DenovoSciences/PCB-PREP400/BOM - GenesisV2/SA1000139 - BOM - Assy, PCBA, Daughter, Genesis V2-Rev_5.xlsx

Sheet: Celsee BOM
 |  |  |  | Document Title | SA1000139 - BOM - Assy, PCBA, Daughter, Genesis V2 |  |  |  |  |  | REV | 5 | This Area Below Is Intentionally Not Printed
 |  |  |  | Document Type | Bill of Materials |  |  |  |  |  | Sheet 1 of 1
 |  |  |  | Issued By | Engineering |  |  |  |  |  | WO size
PLYMOUTH, MICHIGAN 48170 |  |  |  | Celsee Part # | SA1000139 |  |  |  |  |  | WO #
 |  |  |  | Product Desc. | Assy, PCBA, Daughter, Genesis V2
Find No. | Part Number | Part Number Rev | Description |  |  | QTY for 1 Unit | UoM | QTY for WO | Actuals | Celsee Lot/WO # (if available) | Supplier Lot # (if available) | Special Notes | Manufacturer | Manufacturer Part Number | 1st Vendor/Supplier | 1st Vendor/Supplier Part Number | 2nd Vendor/Supplier | 2nd Vendor/Supplier Part Number
1 | 10000387 | 2 | PCB, Prep400 |  |  | 1 | Each | 0 |  |  |  |  |  |  | PCB Universe | 10000387 rev A
2 | 16000004 | OTS | CAP CER 0.1UF 50V X7R 0603 | CAP CER 0.1UF 50V X7R 0603 | CAP CER 0.1UF 50V X7R 0603 | 40 | Each | 0 |  |  |  | C1, C2, C5, C8, C9, C12, C13, C14, C15, C16, C17, C18, C19, C20, C22, C23, C24, C25, C27, C28, C29, C30, C32, C33, C34, C35, C37, C39, C41, C43, C49, C51, C53, C55, C61, C63, C109, C110, C118, C137 | Murata | GCM188R71H104KA57J | Digi-Key | 490-8020-1-ND | Digi-Key
3 | 16000068 | OTS | CAP ALUM POLY 100UF 20% 50V SMD | CAP ALUM POLY 100UF 20% 50V SMD | CAP ALUM POLY 100UF 20% 50V SMD | 4 | Each | 0 |  |  |  | C21, C26, C31, C36 | Panasonic | EEH-ZC1H101V | Digi-Key | P19837CT-ND | Digi-Key | 50PFV100M10X10.5CT-ND
4 | 16000069 | OTS | CAP CER 10UF 10V X5R 0603 | CAP CER 10UF 10V X5R 0603 | CAP CER 10UF 10V X5R 0603 | 4 | Each | 0 |  |  |  | C38, C40, C42, C44 | TDK | C1608X5R1A106K080AC | Digi-Key | 445-7486-1-ND | Digi-Key | 1276-1038-1-ND
5 | 16000070 | OTS | CAP CER 0.22UF 50V X7R 0603 | CAP CER 0.22UF 50V X7R 0603 | CAP CER 0.22UF 50V X7R 0603 | 4 | Each | 0 |  |  |  | C45, C46, C47, C48 | Samsung | CL10B224KB8VPNC | Digi-Key | 1276-6600-1-ND | Digi-Key
6 | 16000071 | OTS | CAP CER 47UF 6.3V X5R 0805 | CAP CER 47UF 6.3V X5R 0805 | CAP CER 47UF 6.3V X5R 0805 | 4 | Each | 0 |  |  |  | C50, C52, C54, C56 | Samsung | CL21A476MQ9LRNC | Digi-Key | 1276-2419-1-ND | Digi-Key
7 | 16000072 | OTS | CAP CER 10000PF 50V X7R 0603 | CAP CER 10000PF 50V X7R 0603 | CAP CER 10000PF 50V X7R 0603 | 36 | Each | 0 |  |  |  | C57, C58, C59, C60, C119, C120, C121, C124, C127, C128, C131, C138, C139, C140, C141, C142, C143, C144, C145, C146, C147, C148, C149, C150, C151, C152, C153, C154, C155, C156, C157, C158, C159, C161, C171, C172 | Murata | GCM188R71H103KA37D | Digi-Key | 490-4778-1-ND | Digi-Key
8 | 16000094 | OTS | DIODE SCHOTTKY 30V 200MA SOT23-3 | DIODE SCHOTTKY 30V 200MA SOT23-3 | DIODE SCHOTTKY 30V 200MA SOT23-3 | 2 | Each | 0 |  |  |  | D1, D3 | Diodes Inc. | BAT54-7-F | Digi-Key | BAT54-FDICT-ND | Digi-Key | BAT54E6327HTSA1
9 | 16000073 | OTS | DIODE ZENER 3.3V 350MW SOT23-3 | DIODE ZENER 3.3V 350MW SOT23-3 | DIODE ZENER 3.3V 350MW SOT23-3 | 2 | Each | 0 |  |  |  | D2, D4 | Micro Commercial | BZX84C3V3-TP | Digi-Key | BZX84C3V3-TPMSCT-ND | Digi-Key
10 | 16000074 | OTS | DIODE GEN PURP 100V 1A SMA | DIODE GEN PURP 100V 1A SMA | DIODE GEN PURP 100V 1A SMA | 6 | Each | 0 |  |  |  | D9, D10, D11, D12, D13, D14 | ON Semi | ES1B | Digi-Key | ES1BFSCT-ND | Digi-Key | CD214A-F1100CT-ND
11 | 16000056 | OTS | DIODE ARRAY SCHOTTKY 30V SOT23-3 | DIODE ARRAY SCHOTTKY 30V SOT23-3 | DIODE ARRAY SCHOTTKY 30V SOT23-3 | 6 | Each | 0 |  |  |  | D15, D16, D17, D18, D27, D28 | ON Semi | BAT54SLT1G | Digi-Key | BAT54SLT1GOSCT-ND | Digi-Key
12 | 16000075 | OTS | DIODE ARRAY GP 70V 200MA SOT23-3 | DIODE ARRAY GP 70V 200MA SOT23-3 | DIODE ARRAY GP 70V 200MA SOT23-3 | 4 | Each | 0 |  |  |  | D19, D20, D21, D22 | Taiwan Semi | BAV99 RFG | Digi-Key | BAV99RFGCT-ND | Digi-Key
13 | 16000095 | OTS | TVS DIODE 12V 19V SMB | TVS DIODE 12V 19V SMB | TVS DIODE 12V 19V SMB | 8 | Each | 0 |  |  |  | D31, D32, D35, D36, D37, D38, D39, D40 | Littlefuse | SACB12 | Digi-Key | SACB12CT-ND | Digi-Key | SMBJ12ABCT-ND
14 | 16000098 | OTS | SENSOR PRESS 5PSI DIFF 3.3V SMD | SENSOR PRESS 5PSI DIFF 3.3V SMD | SENSOR PRESS 5PSI DIFF 3.3V SMD | 2 | Each | 0 |  |  |  | IC1, IC4 | Honeywell | SSCMRRN005PDAA3 | Digi-Key | 480-5530-ND | Digi-Key
15 | 16000020 | OTS | IC MOTOR DRIVER SPI 28HTSSOP | IC MOTOR DRIVER SPI 28HTSSOP | IC MOTOR DRIVER SPI 28HTSSOP | 4 | Each | 0 |  |  |  | IC5, IC6, IC7, IC8 | STMicro | L6472H | Digi-Key | 497-14690-5-ND | Digi-Key | 497-14775-5-ND
16 | 16000076 | OTS | IC MOTOR DRIVER PAR 20-SOIC | IC MOTOR DRIVER PAR 20-SOIC | IC MOTOR DRIVER PAR 20-SOIC | 1 | Each | 0 |  |  |  | IC9 | STMicro | L293DD | Digi-Key | 497-1390-5-ND | Digi-Key | 497-2937-1-ND
17 | 16000021 | OTS | CONN HEADER VERT 2POS .100 30AU | CONN HEADER VERT 2POS .100 30AU | CONN HEADER VERT 2POS .100 30AU | 7 | Each | 0 |  |  |  | J3, J8, J9, J10, J11, J12, J13 | TE | 3-641215-2 | Digi-Key | A30786-ND | Digi-Key | WM2700-ND
18 | 16000022 | OTS | CONN HEADER VERT 3POS .100 30AU | CONN HEADER VERT 3POS .100 30AU | CONN HEADER VERT 3POS .100 30AU | 6 | Each | 0 |  |  |  | J4, J5, J14, J15, J16, J17 | TE | 3-641215-3 | Digi-Key | A30787-ND | Digi-Key | WM2701-ND
19 | 16000023 | OTS | CONN HEADER VERT 4POS .100 30AU | CONN HEADER VERT 4POS .100 30AU | CONN HEADER VERT 4POS .100 30AU | 4 | Each | 0 |  |  |  | J18, J19, J20, J21 | TE | 3-641215-4 | Digi-Key | A30788-ND | Digi-Key | WM2746-ND
20 | 16000077 | OTS | CONN HEADER VERT 5POS .100 30AU | CONN HEADER VERT 5POS .100 30AU | CONN HEADER VERT 5POS .100 30AU | 2 | Each | 0 |  |  |  | J22, J23 | TE | 3-641215-5 | Digi-Key | A30789-ND | Digi-Key | WM2703-ND
21 | 16000078 | OTS | CONN HEADER 2POS .100" SNGL | CONN HEADER 2POS .100" SNGL | CONN HEADER 2POS .100" SNGL | 6 | Each | 0 |  |  |  | JP3, JP4, JP7, JP8, JP9, JP10 | Samtec | TSW-102-07-F-S | Digi-Key | SAM10844-ND | Digi-Key | SAM1031-02-ND
22 | 16000079 | OTS | CONN JUMPER SHORTING .100" GOLD | CONN JUMPER SHORTING .100" GOLD | CONN JUMPER SHORTING .100" GOLD | 6 | Each | 0 |  |  |  | JP3, JP4, JP7, JP8, JP9, JP10 (Populate Jumper on Headers, to short Pin1 and Pin2) | Sullins | QPC02SXGN-RC | Digi-Key | S9337-ND | Digi-Key | S9001-ND
23 | 16000080 | OTS | .025" BOARD SPACERS | .025" BOARD SPACERS | .025" BOARD SPACERS | 1 | Each | 0 |  |  |  | P1 | Samtec | DW-11-11-F-D-665 | Digi-Key | DW-11-11-F-D-665-ND | Digi-Key
24 | 16000081 | OTS | MOSFET N-CH 60V 2.8A SOT-223 | MOSFET N-CH 60V 2.8A SOT-223 | MOSFET N-CH 60V 2.8A SOT-223 | 6 | Each | 0 |  |  |  | Q2, Q3, Q4, Q5, Q6, Q7 | ON Semi | FQT13N06LTF | Digi-Key | FQT13N06LTFCT-ND | Digi-Key
25 | 16000082 | OTS | RES SMD 330 OHM 1% 1/10W 0603 | RES SMD 330 OHM 1% 1/10W 0603 | RES SMD 330 OHM 1% 1/10W 0603 | 6 | Each | 0 |  |  |  | R19, R20, R21, R22, R27, R28 | Samsung | RC1608F331CS | Digi-Key | 1276-4604-1-ND | Digi-Key | CR0603-FX-3300ELFCT-ND
26 | 16000083 | OTS | RES SMD 10K OHM 1% 1/10W 0603 | RES SMD 10K OHM 1% 1/10W 0603 | RES SMD 10K OHM 1% 1/10W 0603 | 9 | Each | 0 |  |  |  | R23, R24, R25, R26, R29, R30, R39, R41, R43 | Panasonic | ERJ-3EKF1002V | Digi-Key | P10.0KHCT-ND | Digi-Key
27 | 16000096 | OTS | RES SMD 100 OHM 1% 1/10W 0603 | RES SMD 100 OHM 1% 1/10W 0603 | RES SMD 100 OHM 1% 1/10W 0603 | 16 | Each | 0 |  |  |  | R3, R5, R31, R33, R35, R37, R45, R47, R59, R60, R63, R64, R65, R66, R67, R68 | Panasonic | ERJ-3EKF1000V | Digi-Key | P100HCT-ND | Digi-Key
28 | 16000097 | OTS | RES SMD 1.5K OHM 1% 1/10W 0603 | RES SMD 1.5K OHM 1% 1/10W 0603 | RES SMD 1.5K OHM 1% 1/10W 0603 | 2 | Each | 0 |  |  |  | R4, R6 | Samsung | RC1608F152CS | Digi-Key | 1276-4660-1-ND | Digi-Key | CR0603-FX-1501ELFCT-ND
29 | 16000084 | OTS | RES SMD 100K OHM 1% 1/10W 0603 | RES SMD 100K OHM 1% 1/10W 0603 | RES SMD 100K OHM 1% 1/10W 0603 | 6 | Each | 0 |  |  |  | R11, R12, R55, R56, R73, R76 | Panasonic | ERJ-3EKF1003V | Digi-Key | P100KHCT-ND | Digi-Key
30 | 16000037 | OTS | RES SMD 1K OHM 1% 1/10W 0603 | RES SMD 1K OHM 1% 1/10W 0603 | RES SMD 1K OHM 1% 1/10W 0603 | 8 | Each | 0 |  |  |  | R15, R18, R32, R34, R36, R38, R46, R48 | Panasonic | ERJ-3EKF1001V | Digi-Key | P1.00KHCT-ND | Digi-Key
31 | 16000085 | OTS | RES SMD 39K OHM 1% 1/10W 0603 | RES SMD 39K OHM 1% 1/10W 0603 | RES SMD 39K OHM 1% 1/10W 0603 | 1 | Each | 0 |  |  |  | R40 | Panasonic | ERJ-3EKF3902V | Digi-Key | P39.0KHCT-ND | Digi-Key
32 | 16000060 | OTS | RES SMD 0 OHM JUMPER 1/10W 0603 | RES SMD 0 OHM JUMPER 1/10W 0603 | RES SMD 0 OHM JUMPER 1/10W 0603 | 2 | Each | 0 |  |  |  | R71, R72 | Panasonic | ERJ-3GEY0R00V | Digi-Key | P0.0GCT-ND | Digi-Key | RMCF0603ZT0R00CT-ND
33 | 16000086 | OTS | PC TEST POINT COMPACT BLACK | PC TEST POINT COMPACT BLACK | PC TEST POINT COMPACT BLACK | 4 | Each | 0 |  |  |  | TP19, TP20, TP21, TP22 | Keystone | 5006 | Digi-Key | 36-5006-ND | Digi-Key | 36-5123-ND
34 | 16000087 | OTS | CONN HEADER FMAL 12PS.1" DL GOLD | CONN HEADER FMAL 12PS.1" DL GOLD | CONN HEADER FMAL 12PS.1" DL GOLD | 1 | Each | 0 |  |  |  | U1 Goes to U1-4 (12-pos, Mate: 609-3213-ND) | Sullins | PPPC062LFBN-RC | Digi-Key | S7109-ND | Digi-Key | S7074-ND
35 | 16000088 | OTS | CONN HEADER FMAL 16PS.1" DL GOLD | CONN HEADER FMAL 16PS.1" DL GOLD | CONN HEADER FMAL 16PS.1" DL GOLD | 2 | Each | 0 |  |  |  | U1 Goes to U1-1 and U1-3 (16-pos, Mate: 609-3389-ND) | Sullins | PPPC082LFBN-RC | Digi-Key | S7111-ND | Digi-Key | S7076-ND
36 | 16000089 | OTS | CONN HEADER FEM 20POS.1" DL GOLD | CONN HEADER FEM 20POS.1" DL GOLD | CONN HEADER FEM 20POS.1" DL GOLD | 1 | Each | 0 |  |  |  | U1 Goes to U1-2 (20-pos, Mate: 609-3214-ND) | Sullins | PPPC102LFBN-RC | Digi-Key | S6106-ND | Digi-Key | S7078-ND
37 | 16000090 | OTS | FREEDOM BOARD KINETIS L | FREEDOM BOARD KINETIS L | FREEDOM BOARD KINETIS L | 1 | Each | 0 |  |  |  | U1 Motherboard. Remove D8, D11 from FRDM-KL25Z | NXP | FRDM-KL25Z | Digi-Key | FRDM-KL25Z-ND | Digi-Key
38 | 16000091 | OTS | CONN HEADER 12POS .100 STR 15AU | CONN HEADER 12POS .100 STR 15AU | CONN HEADER 12POS .100 STR 15AU | 1 | Each | 0 |  |  |  | U1 Goes to J10 of FRDM-KL25Z | Amphenol | 67996-212HLF | Digi-Key | 609-3213-ND | Digi-Key | 609-3204-ND, 609-3219-ND
39 | 16000092 | OTS | CONN HEADER 16POS .100 STR 15AU |  |  | 2 | Each | 0 |  |  |  | U1 Goes to J1, J9 of FRDM-KL25Z | Amphenol | 67996-216HLF | Digi-Key | 609-3389-ND | Digi-Key | 609-3205-ND, 609-3220-ND
40 | 16000093 | OTS | CONN HEADER 20POS .100 STR 15AU | CONN HEADER 16POS .100 STR 15AU | CONN HEADER 16POS .100 STR 15AU | 1 | Each | 0 |  |  |  | U1 Goes to J2 of FRDM-KL25Z | Amphenol | 67996-220HLF | Digi-Key | 609-3214-ND | Digi-Key | 609-3206-ND, 609-3221-ND
Comments: |  |  |  |  |  |  |  |  |  |  |  |  | This Area Above Is Intentionally Not Printed
Signature: |  |  |  |  | Date:
PROPRIETARY AND CONFIDENTIAL: The information contained in this document is the property of Celsee, Inc. Any reproduction in whole or in part without the written permission of Celsee, Inc is prohibited. PRINTED COPIES OF THIS DOCUMENT ARE NOT CONTROLLED

Sheet: Daughter Board, Rev 5, 20181220
Bill of Material
Product: | Genesis V2
Revision: | 5
PCBA PartNum: | SA1000139 | Rev. 4
PCB PartNum: | 10000387 | Rev. 2
CelseePartNum | Rev. | References | Quantity | Description | Mfg | MfgPartNum | DigikeyPartNum | AltDigikeyPartNum | Notes
16000004 | N/A | C1, C2, C5, C8, C9, C12, C13, C14, C15, C16, C17, C18, C19, C20, C22, C23, C24, C25, C27, C28, C29, C30, C32, C33, C34, C35, C37, C39, C41, C43, C49, C51, C53, C55, C61, C63, C109, C110, C118, C137 | 40 | CAP CER 0.1UF 50V X7R 0603 | Murata | GCM188R71H104KA57J | 490-8020-1-ND
 |  | (C3, C4, C6, C7, C10, C11, C62, C64, C65, C66, C67, C68, C70, C71, C72, C73, C75, C76, C77, C78, C80, C81, C82, C83, C85, C87, C89, C91, C97, C99, C101, C103, C111, C112, C116, C132, C163, C165, C167, C169, C191, C193, C195, C197)* | 44 |  |  |  |  |  | *Do Not Populate
 |  | (C113)* | 1 | CAP CER 0.1UF 100V X7R 1206 | Kemet | C1206C104K1RACAUTO | 399-7008-1-ND | 445-5840-1-ND | *Do Not Populate
16000068 | N/A | C21, C26, C31, C36 | 4 | CAP ALUM POLY 100UF 20% 50V SMD | Panasonic | EEH-ZC1H101V | P19837CT-ND | 50PFV100M10X10.5CT-ND
 |  | (C69, C74, C79, C84)* | 4 |  |  |  |  |  | *Do Not Populate
16000069 | N/A | C38, C40, C42, C44 | 4 | CAP CER 10UF 10V X5R 0603 | TDK | C1608X5R1A106K080AC | 445-7486-1-ND | 1276-1038-1-ND
 |  | (C86, C88, C90, C92)* | 4 |  |  |  |  |  | *Do Not Populate
16000070 | N/A | C45, C46, C47, C48 | 4 | CAP CER 0.22UF 50V X7R 0603 | Samsung | CL10B224KB8VPNC | 1276-6600-1-ND
 |  | (C93, C94, C95, C96)* | 4 |  |  |  |  |  | *Do Not Populate
16000071 | N/A | C50, C52, C54, C56 | 4 | CAP CER 47UF 6.3V X5R 0805 | Samsung | CL21A476MQ9LRNC | 1276-2419-1-ND
 |  | (C136, C98, C100, C102, C104)* | 5 |  |  |  |  |  | *Do Not Populate
 |  | (C115)* | 1 | CAP CER 47UF 6.3V X5R 1206 | Samsung | CL31A476KQHNNNE | 1276-3062-1-ND |  | *Do Not Populate
16000072 | N/A | C57, C58, C59, C60, C119, C120, C121, C124, C127, C128, C131, C138, C139, C140, C141, C142, C143, C144, C145, C146, C147, C148, C149, C150, C151, C152, C153, C154, C155, C156, C157, C158, C159, C161, C171, C172 | 36 | CAP CER 10000PF 50V X7R 0603 | Murata | GCM188R71H103KA37D | 490-4778-1-ND
 |  | (C105, C106, C107, C108, C117, C122, C123, C125, C126, C129, C130, C133, C134, C160, C162, C164, C166, C168, C170, C173, C174, C175, C176, C177, C178, C179, C180, C181, C182, C183, C184, C185, C186, C187, C188, C189, C190, C192, C194, C196, C198)* | 41 |  |  |  |  |  | *Do Not Populate
 |  | (C114)* | 1 | CAP CER 10000PF 200V X7R 1206 | AVX | 12062C103K4T2A | 478-9898-1-ND |  | *Do Not Populate
 |  | (C135)* | 1 | CAP CER 10PF 50V C0G/NP0 0603 | Samsung | CL10C100JB81PNC | 1276-2153-1-ND |  | *Do Not Populate
16000094 | N/A | D1, D3 | 2 | DIODE SCHOTTKY 30V 200MA SOT23-3 | Diodes Inc. | BAT54-7-F | BAT54-FDICT-ND | BAT54E6327HTSA1
 |  | (D5, D7)* | 2 |  |  |  |  |  | *Do Not Populate
16000073 | N/A | D2, D4 | 2 | DIODE ZENER 3.3V 350MW SOT23-3 | Micro Commercial | BZX84C3V3-TP | BZX84C3V3-TPMSCT-ND
 |  | (D6, D8)* | 2 |  |  |  |  |  | *Do Not Populate
16000074 | N/A | D9, D10, D11, D12, D13, D14 | 6 | DIODE GEN PURP 100V 1A SMA | ON Semi | ES1B | ES1BFSCT-ND | CD214A-F1100CT-ND
16000056 | N/A | D15, D16, D17, D18, D27, D28 | 6 | DIODE ARRAY SCHOTTKY 30V SOT23-3 | ON Semi | BAT54SLT1G | BAT54SLT1GOSCT-ND
 |  | (D29, D30)* | 2 |  |  |  |  |  | *Do Not Populate
16000075 | N/A | D19, D20, D21, D22 | 4 | DIODE ARRAY GP 70V 200MA SOT23-3 | Taiwan Semi | BAV99 RFG | BAV99RFGCT-ND
 |  | (D23, D24, D25, D26)* | 4 |  |  |  |  |  | *Do Not Populate
16000095 | N/A | D31, D32, D35, D36, D37, D38, D39, D40 | 8 | TVS DIODE 12V 19V SMB | Littlefuse | SACB12 | SACB12CT-ND | SMBJ12ABCT-ND
 |  | (D33, D34, D41, D42)* | 4 |  |  |  |  |  | *Do Not Populate
16000098 | N/A | IC1, IC4 | 2 | SENSOR PRESS 5PSI DIFF 3.3V SMD | Honeywell | SSCMRRN005PDAA3 | 480-5530-ND
 |  | (IC2, IC3)* | 2 |  |  |  |  |  | *Do Not Populate
16000020 | N/A | IC5, IC6, IC7, IC8 | 4 | IC MOTOR DRIVER SPI 28HTSSOP | STMicro | L6472H | 497-14690-5-ND | 497-14775-5-ND
 |  | (IC11, IC12, IC13, IC14)* | 4 |  |  |  |  |  | *Do Not Populate
16000076 | N/A | IC9 | 1 | IC MOTOR DRIVER PAR 20-SOIC | STMicro | L293DD | 497-1390-5-ND | 497-2937-1-ND
 |  | (IC10)* | 1 |  |  |  |  |  | *Do Not Populate
 |  | (J1)* | 1 | CONN HEADER 4POS VERT .156 GOLD | TE | 3-641209-4 | A105038-ND | WM5226-ND | *Do Not Populate
16000021 | N/A | J3, J8, J9, J10, J11, J12, J13 | 7 | CONN HEADER VERT 2POS .100 30AU | TE | 3-641215-2 | A30786-ND | WM2700-ND
 |  | (J2)* | 1 |  |  |  |  |  | *Do Not Populate
16000022 | N/A | J4, J5, J14, J15, J16, J17 | 6 | CONN HEADER VERT 3POS .100 30AU | TE | 3-641215-3 | A30787-ND | WM2701-ND
 |  | (J6, J7)* | 2 |  |  |  |  |  | *Do Not Populate
16000023 | N/A | J18, J19, J20, J21 | 4 | CONN HEADER VERT 4POS .100 30AU | TE | 3-641215-4 | A30788-ND | WM2746-ND
 |  | (J26, J27, J28, J29)* | 4 |  |  |  |  |  | *Do Not Populate
16000077 | N/A | J22, J23 | 2 | CONN HEADER VERT 5POS .100 30AU | TE | 3-641215-5 | A30789-ND | WM2703-ND
 |  | (J24, J25)* | 2 |  |  |  |  |  | *Do Not Populate
16000078 | N/A | JP3, JP4, JP7, JP8, JP9, JP10 | 6 | CONN HEADER 2POS .100" SNGL | Samtec | TSW-102-07-F-S | SAM10844-ND | SAM1031-02-ND | Jumper Header
16000079 | N/A |  | 6 | CONN JUMPER SHORTING .100" GOLD | Sullins | QPC02SXGN-RC | S9337-ND | S9001-ND | Populate Jumper on Headers
 |  | (JP1, JP2, JP5, JP6, JP11, JP12)* | 6 |  |  |  |  |  | *Do Not Populate
 |  | (L1)* | 1 | FERRITE BEAD 50 OHM 1206 1LN | Murata | BLM31SN500SH1L | 490-13268-1-ND | 490-13270-1-ND | *Do Not Populate
 |  | (L2, L3, L4, L5, L6, L7, L8, L9, L10, L11, L12)* | 11 | FERRITE BEAD 1 KOHM 0805 1LN | TDK | MPZ2012S102ATD25 | 445-172904-1-ND | 445-5223-1-ND | *Do Not Populate
16000080 | N/A | P1 | 1 | .025" BOARD SPACERS | Samtec | DW-11-11-F-D-665 | DW-11-11-F-D-665-ND |  | Not stocked. Long lead time component.
16000081 | N/A | Q2, Q3, Q4, Q5, Q6, Q7 | 6 | MOSFET N-CH 60V 2.8A SOT-223 | ON Semi | FQT13N06LTF | FQT13N06LTFCT-ND
 |  | (Q1)* | 1 |  |  |  |  |  | *Do Not Populate
16000082 | N/A | R19, R20, R21, R22, R27, R28 | 6 | RES SMD 330 OHM 1% 1/10W 0603 | Samsung | RC1608F331CS | 1276-4604-1-ND | CR0603-FX-3300ELFCT-ND
 |  | (R1)* | 1 |  |  |  |  |  | *Do Not Populate
16000083 | N/A | R23, R24, R25, R26, R29, R30, R39, R41, R43 | 9 | RES SMD 10K OHM 1% 1/10W 0603 | Panasonic | ERJ-3EKF1002V | P10.0KHCT-ND
 |  | (R2, R42, R44, R49)* | 4 |  |  |  |  |  | *Do Not Populate
16000096 | N/A | R3, R5, R31, R33, R35, R37, R45, R47, R59, R60, R63, R64, R65, R66, R67, R68 | 16 | RES SMD 100 OHM 1% 1/10W 0603 | Panasonic | ERJ-3EKF1000V | P100HCT-ND
 |  | (R7, R9, R51, R53, R61, R62, R69, R70)* | 8 |  |  |  |  |  | *Do Not Populate
16000097 | N/A | R4, R6 | 2 | RES SMD 1.5K OHM 1% 1/10W 0603 | Samsung | RC1608F152CS | 1276-4660-1-ND | CR0603-FX-1501ELFCT-ND
 |  | (R8, R10)* | 2 |  |  |  |  |  | *Do Not Populate
16000084 | N/A | R11, R12, R55, R56, R73, R76 | 6 | RES SMD 100K OHM 1% 1/10W 0603 | Panasonic | ERJ-3EKF1003V | P100KHCT-ND
 |  | (R13, R14, R57, R58, R74, R75)* | 6 |  |  |  |  |  | *Do Not Populate
16000037 | N/A | R15, R18, R32, R34, R36, R38, R46, R48 | 8 | RES SMD 1K OHM 1% 1/10W 0603 | Panasonic | ERJ-3EKF1001V | P1.00KHCT-ND
 |  | (R16, R17, R52, R54)* | 4 |  |  |  |  |  | *Do Not Populate
16000085 | N/A | R40 | 1 | RES SMD 39K OHM 1% 1/10W 0603 | Panasonic | ERJ-3EKF3902V | P39.0KHCT-ND
 |  | (R50)* | 1 |  |  |  |  |  | *Do Not Populate
16000060 | N/A | R71, R72 | 2 | RES SMD 0 OHM JUMPER 1/10W 0603 | Panasonic | ERJ-3GEY0R00V | P0.0GCT-ND | RMCF0603ZT0R00CT-ND
 |  | (TP1, TP2, TP3, TP4, TP5, TP6, TP7, TP8, TP9, TP10, TP11, TP12, TP13, TP14, TP15, TP16, TP17, TP18, TP23, TP24, TP25, TP26, TP27, TP28, TP29, TP30, TP31, TP32, TP33, TP34, TP35, TP36, TP37, TP38, TP39, TP40, TP41, TP42, TP43, TP44, TP45, TP46, TP47, TP48, TP49, TP50, TP51, TP52, TP53, TP54, TP55, TP56)* | 52 | PC TEST POINT NATURAL | Harwin | S2761-46R | 952-2665-1-ND | A106145CT-ND | *Do Not Populate
16000086 | N/A | TP19, TP20, TP21, TP22 | 4 | PC TEST POINT COMPACT BLACK | Keystone | 5006 | 36-5006-ND | 36-5123-ND
16000087 | N/A | U1 | 1 | CONN HEADER FMAL 12PS.1" DL GOLD | Sullins | PPPC062LFBN-RC | S7109-ND | S7074-ND | Goes to U1-4 (12-pos, Mate: 609-3213-ND)
16000088 | N/A |  | 2 | CONN HEADER FMAL 16PS.1" DL GOLD | Sullins | PPPC082LFBN-RC | S7111-ND | S7076-ND | Goes to U1-1 and U1-3 (16-pos, Mate: 609-3389-ND)
16000089 | N/A |  | 1 | CONN HEADER FEM 20POS.1" DL GOLD | Sullins | PPPC102LFBN-RC | S6106-ND | S7078-ND | Goes to U1-2 (20-pos, Mate: 609-3214-ND)
16000090 | N/A |  | 1 | FREEDOM BOARD KINETIS L | NXP | FRDM-KL25Z | FRDM-KL25Z-ND |  | Motherboard. Remove D8, D11 from FRDM-KL25Z
16000091 | N/A |  | 1 | CONN HEADER 12POS .100 STR 15AU | Amphenol | 67996-212HLF | 609-3213-ND | 609-3204-ND, 609-3219-ND | Goes to J10 of FRDM-KL25Z
16000092 | N/A |  | 2 | CONN HEADER 16POS .100 STR 15AU | Amphenol | 67996-216HLF | 609-3389-ND | 609-3205-ND, 609-3220-ND | Goes to J1, J9 of FRDM-KL25Z
16000093 | N/A |  | 1 | CONN HEADER 20POS .100 STR 15AU | Amphenol | 67996-220HLF | 609-3214-ND | 609-3206-ND, 609-3221-ND | Goes to J2 of FRDM-KL25Z
