DenovoSciences/PCB-PREP400/Drills/PREP400-drl_map.dxf

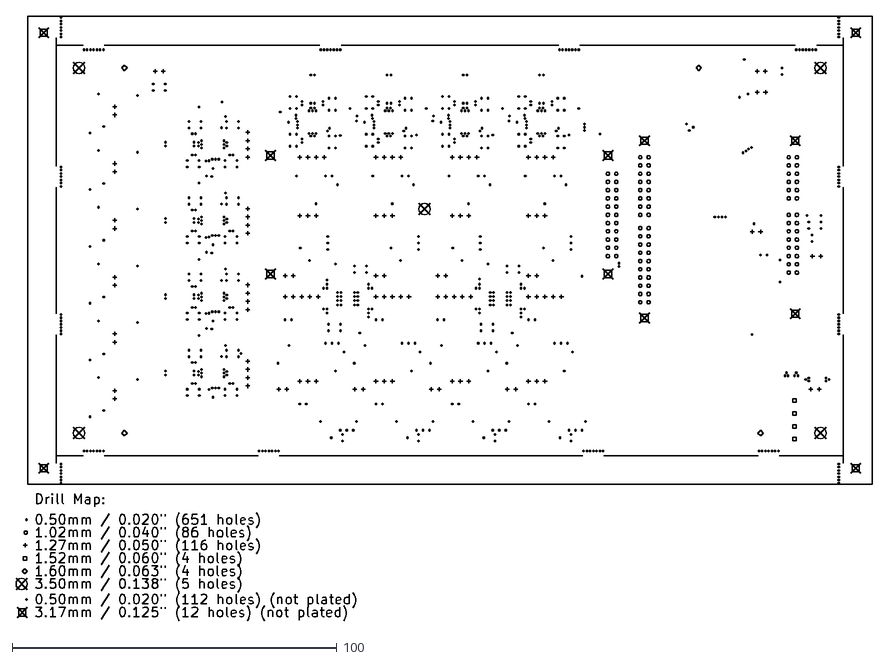
[picture p1: CAD file, 2019-04-02]
Drills/PREP400-drl_map.dxf
263.8 x 186.1
