DenovoSciences/PCB-PREP400/Schematic/GenesisV2DaughterSchem.pdf

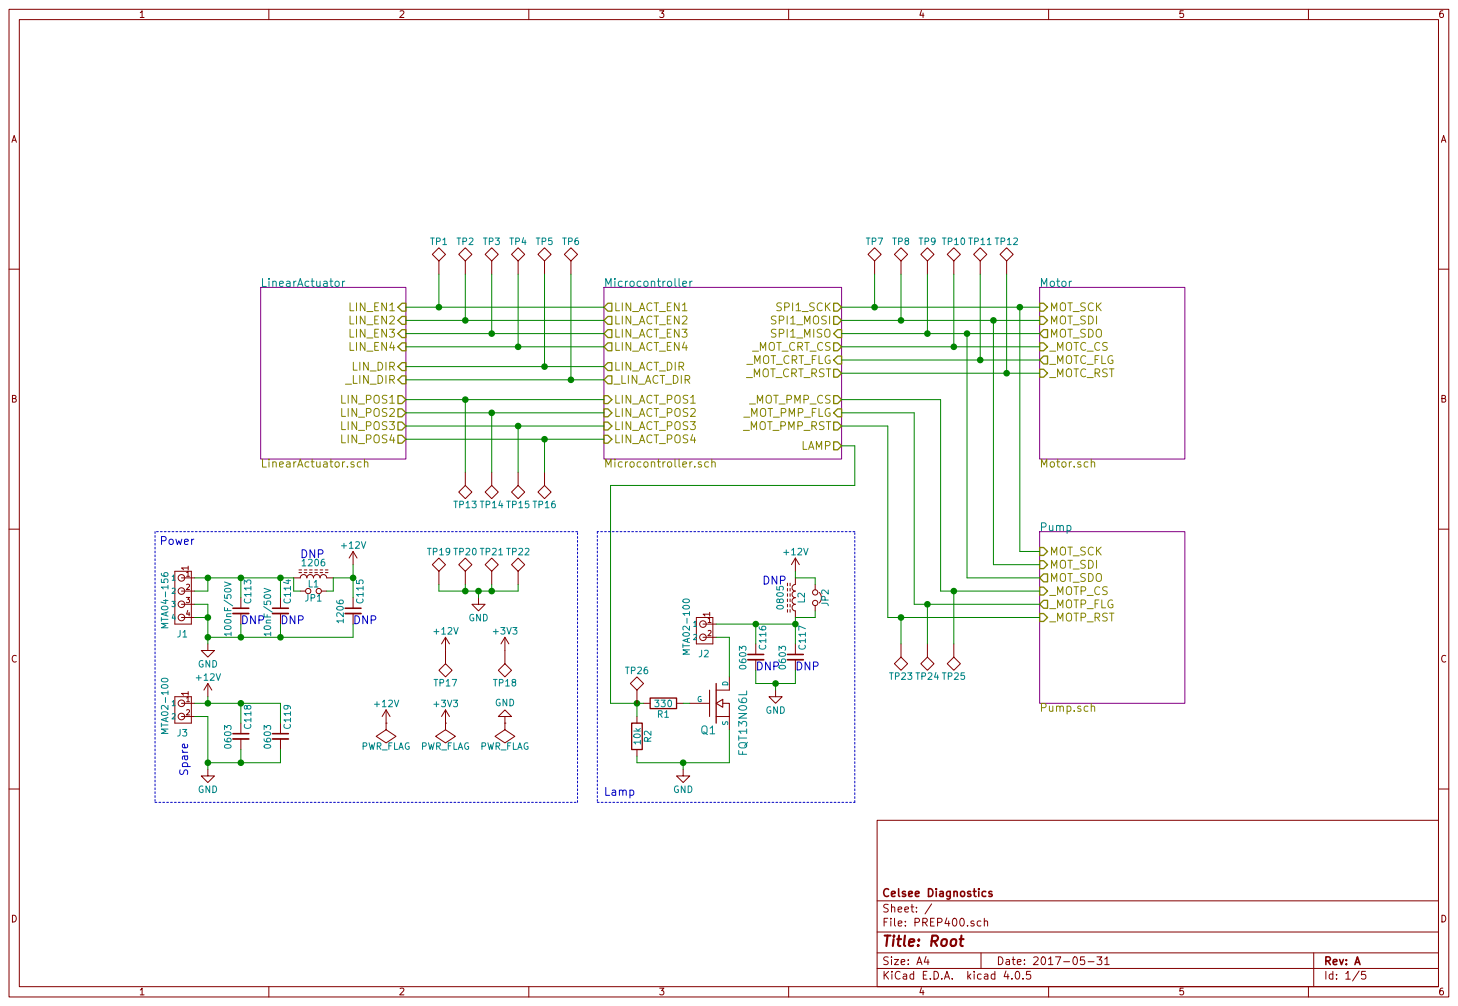
[picture p2: page 1]

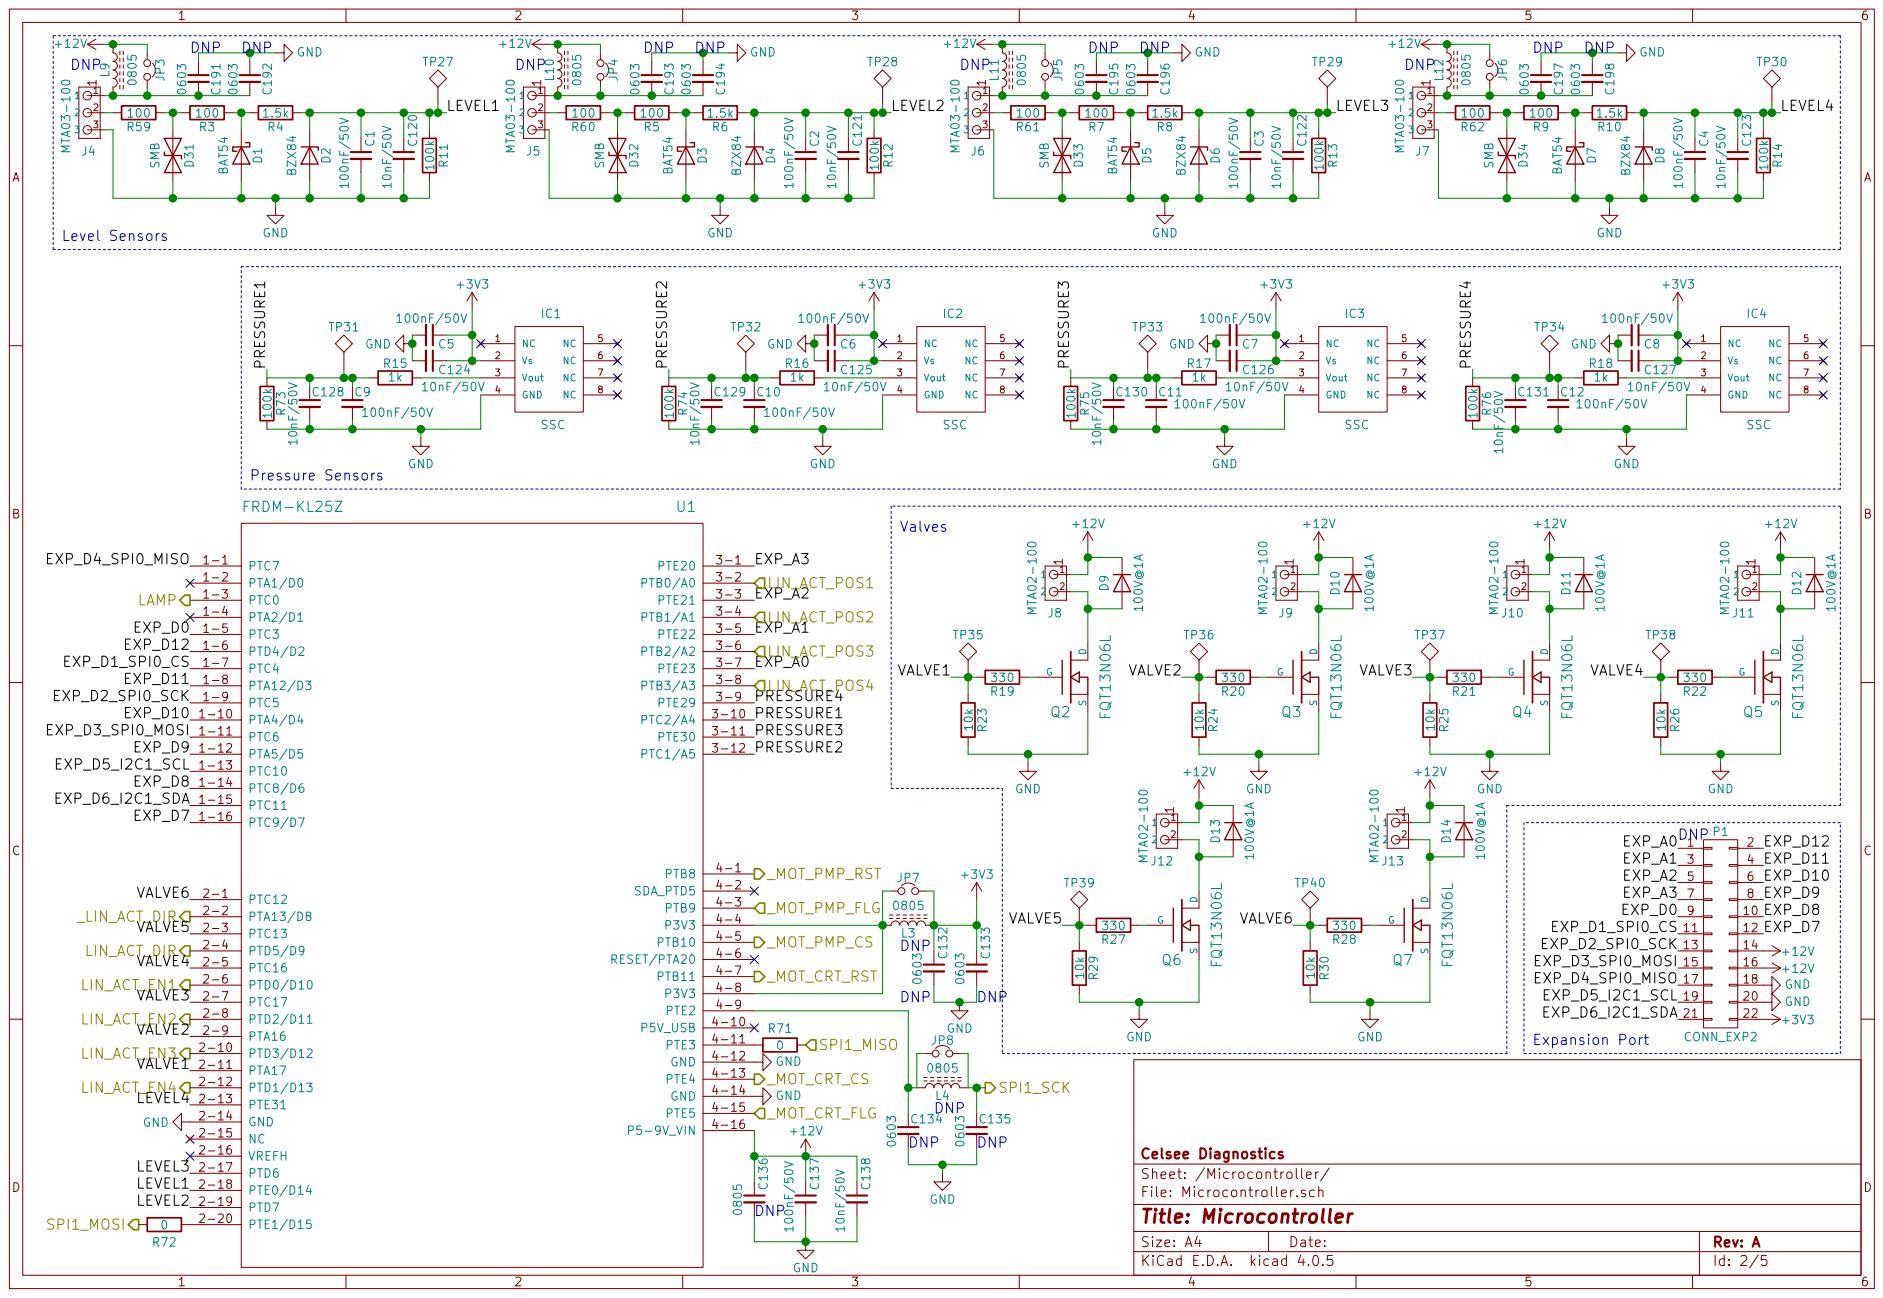
[picture p3: page 2]

Id: 2/5 Title: Microcontroller File: Microcontroller.sch Sheet: /Microcontroller/ Celsee Diagnostics

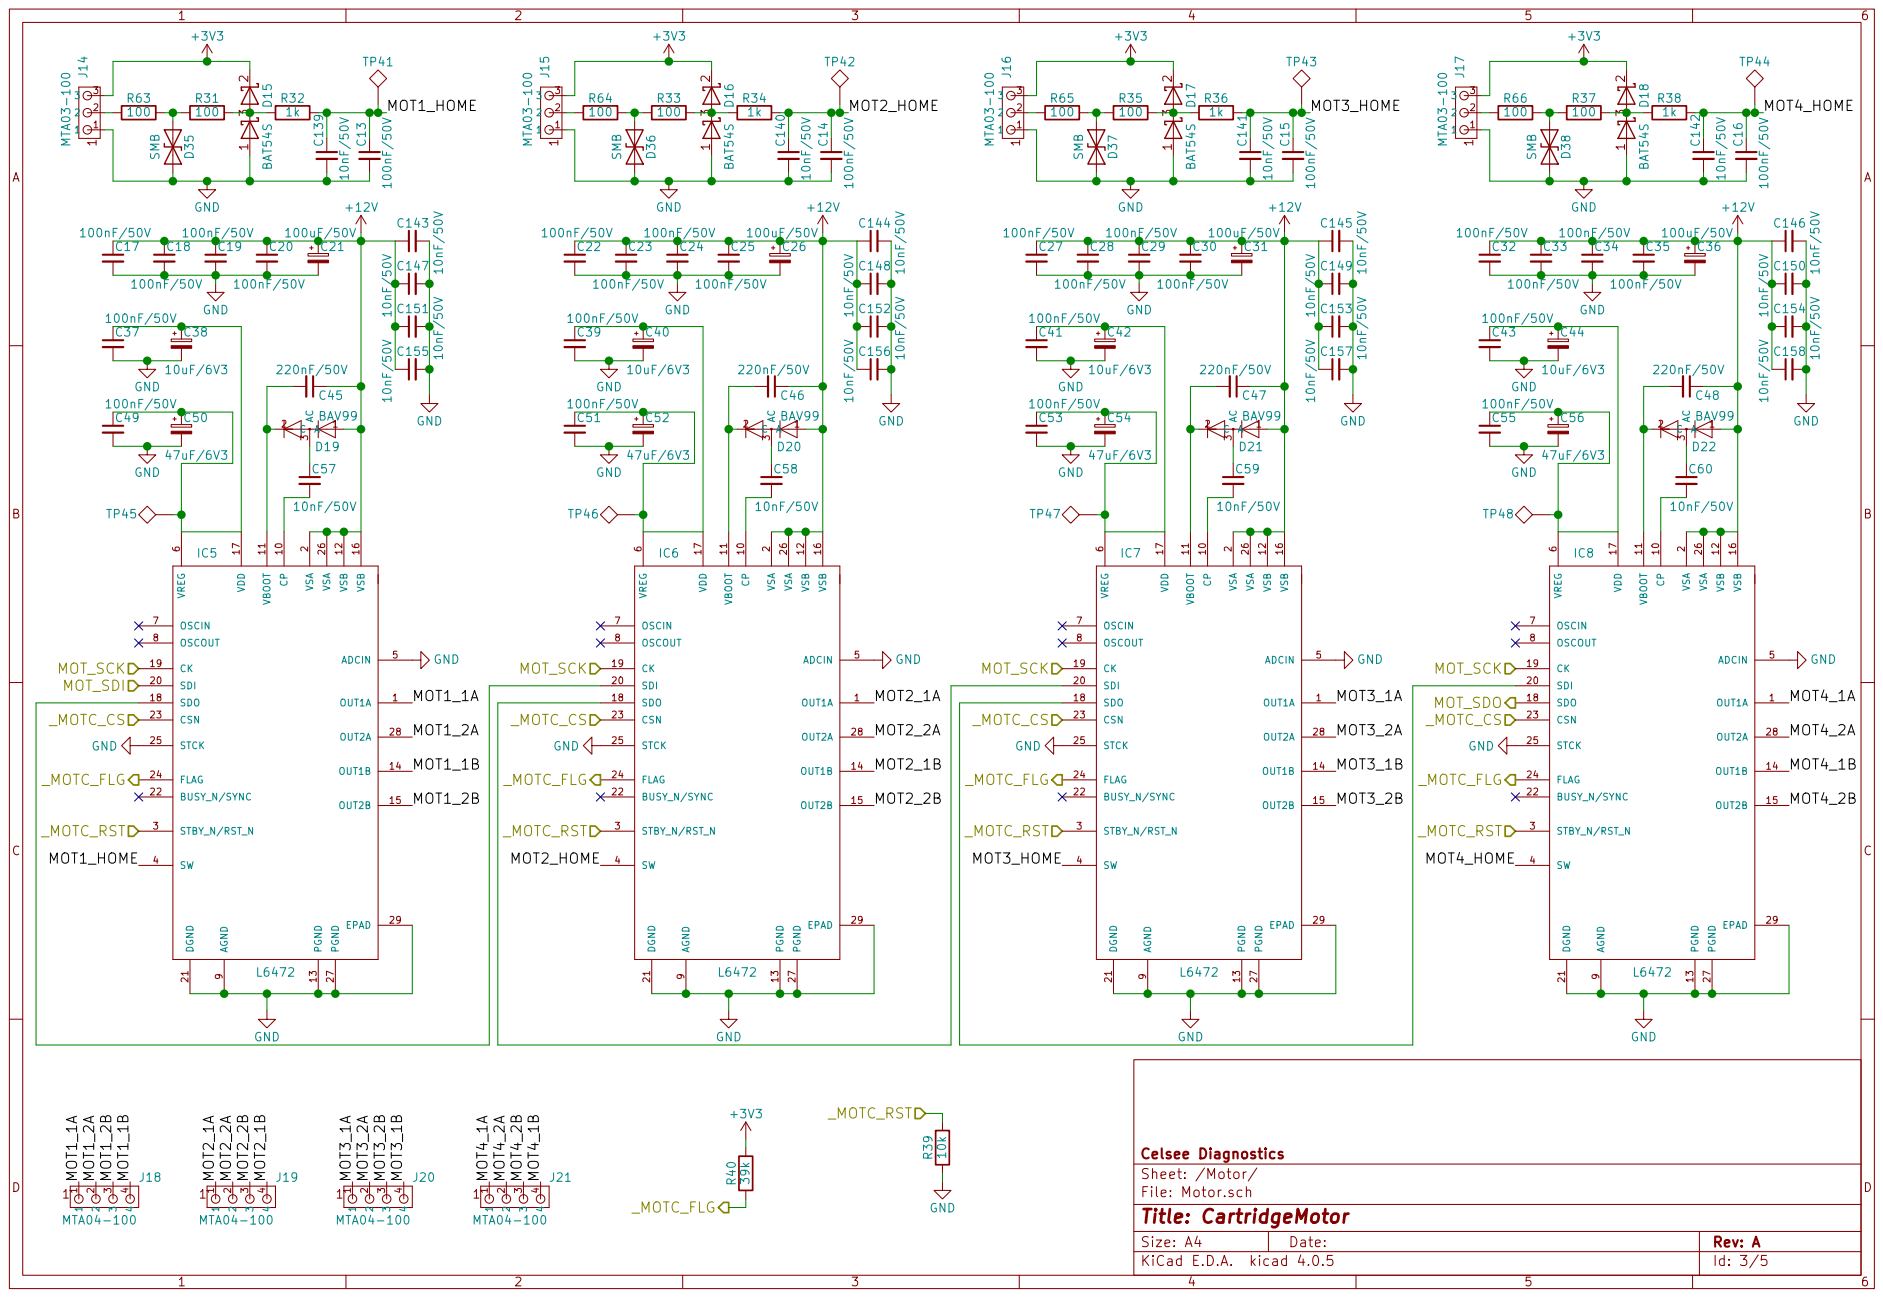
[picture p4: page 3]

9 CP 10 SDI 20 VBOOT 11 DGND 21 VSB 12 BUSY_N/SYNC 22 PGND 13 CSN 23 OUT1B 14 FLAG 24 OUT2B 15 STCK 25 VSB 16 VSA 26 VDD 17 PGND 27 SDO 18 OUT2A 28 CK 19 EPAD 29

Id: 3/5 Title: CartridgeMotor File: Motor.sch Sheet: /Motor/ Celsee Diagnostics

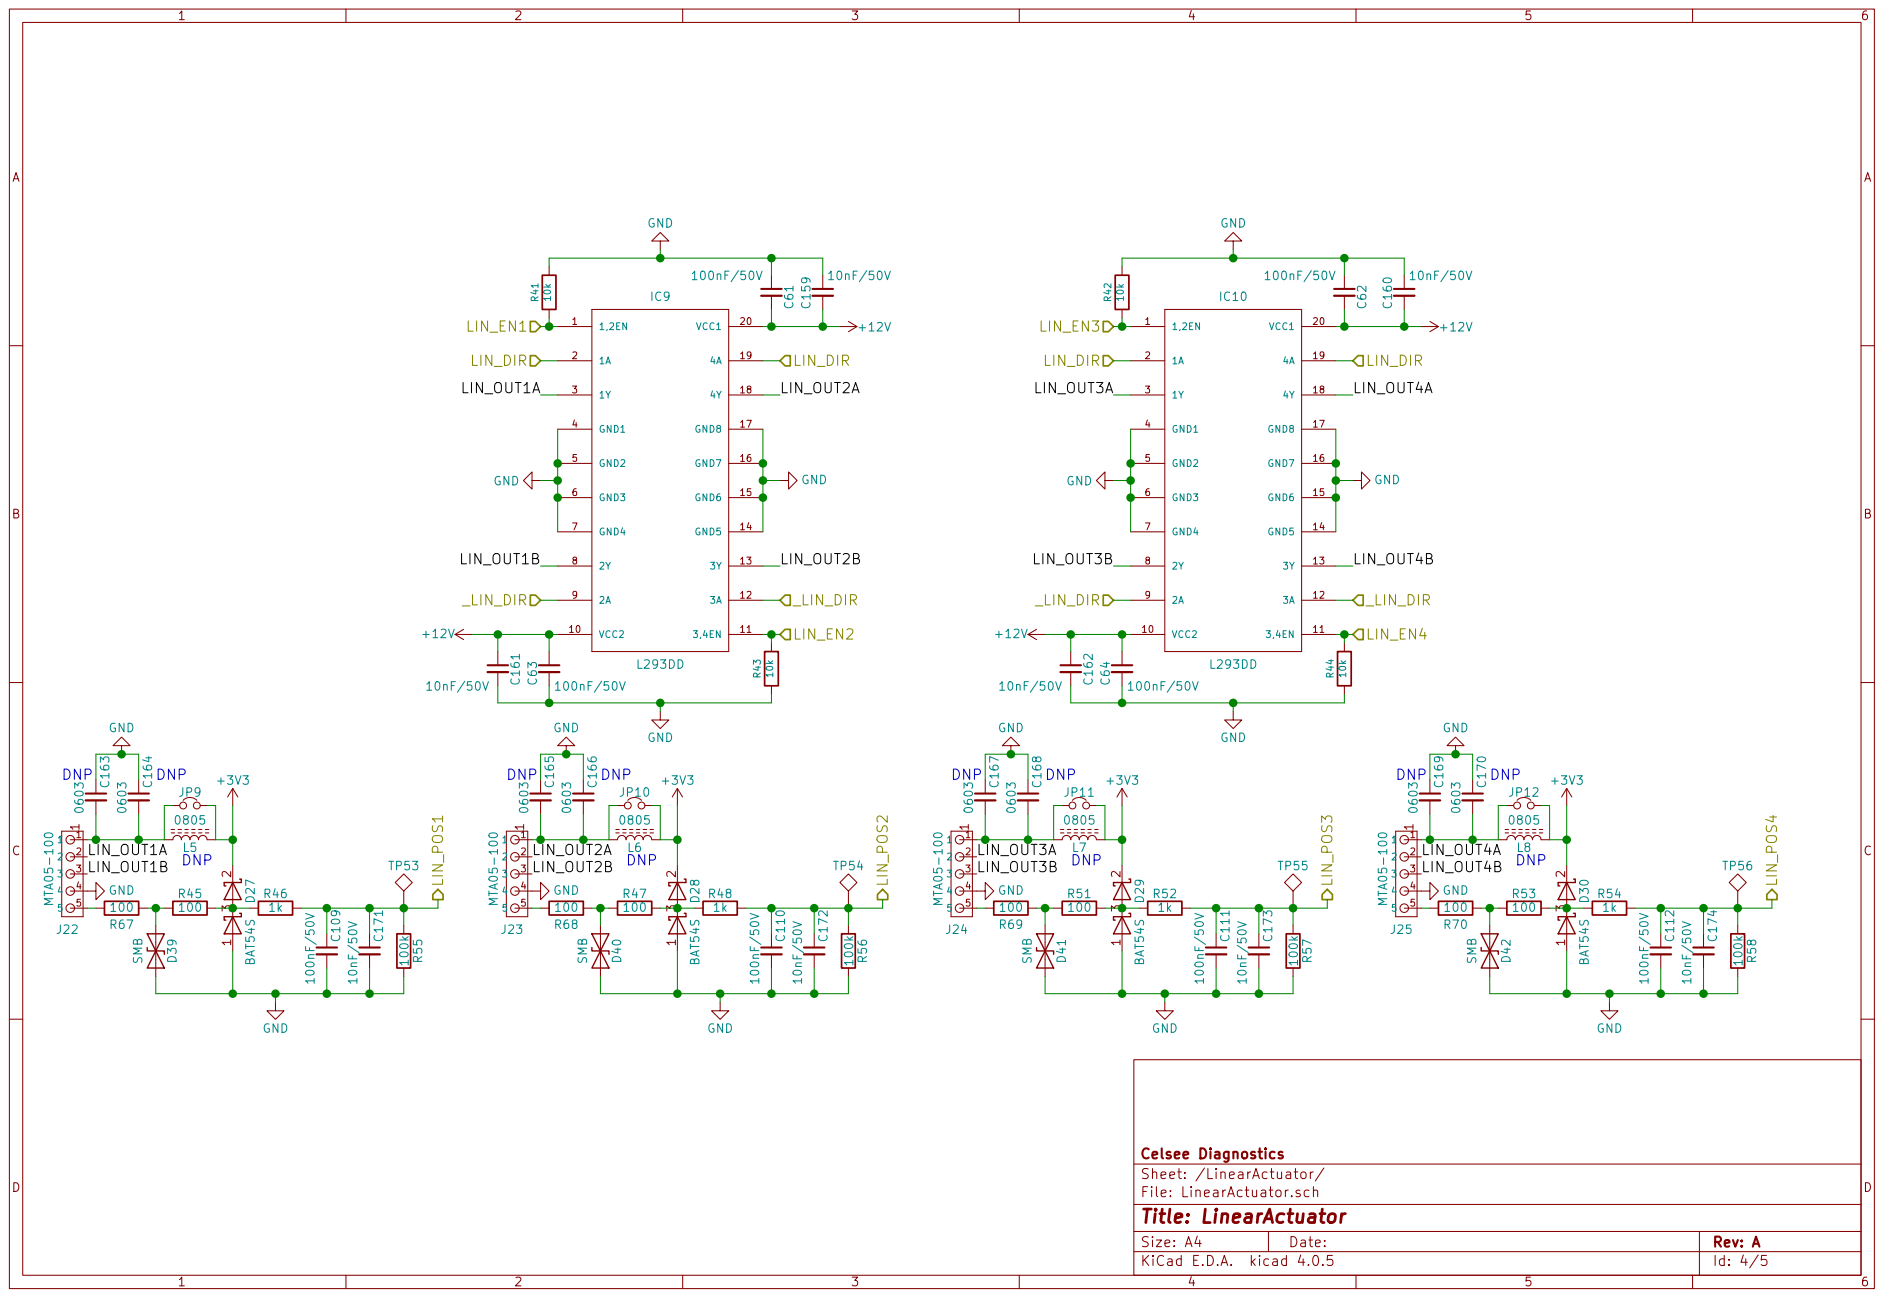
[picture p5: page 4]

Id: 4/5 Title: LinearActuator File: LinearActuator.sch Sheet: /LinearActuator/ Celsee Diagnostics

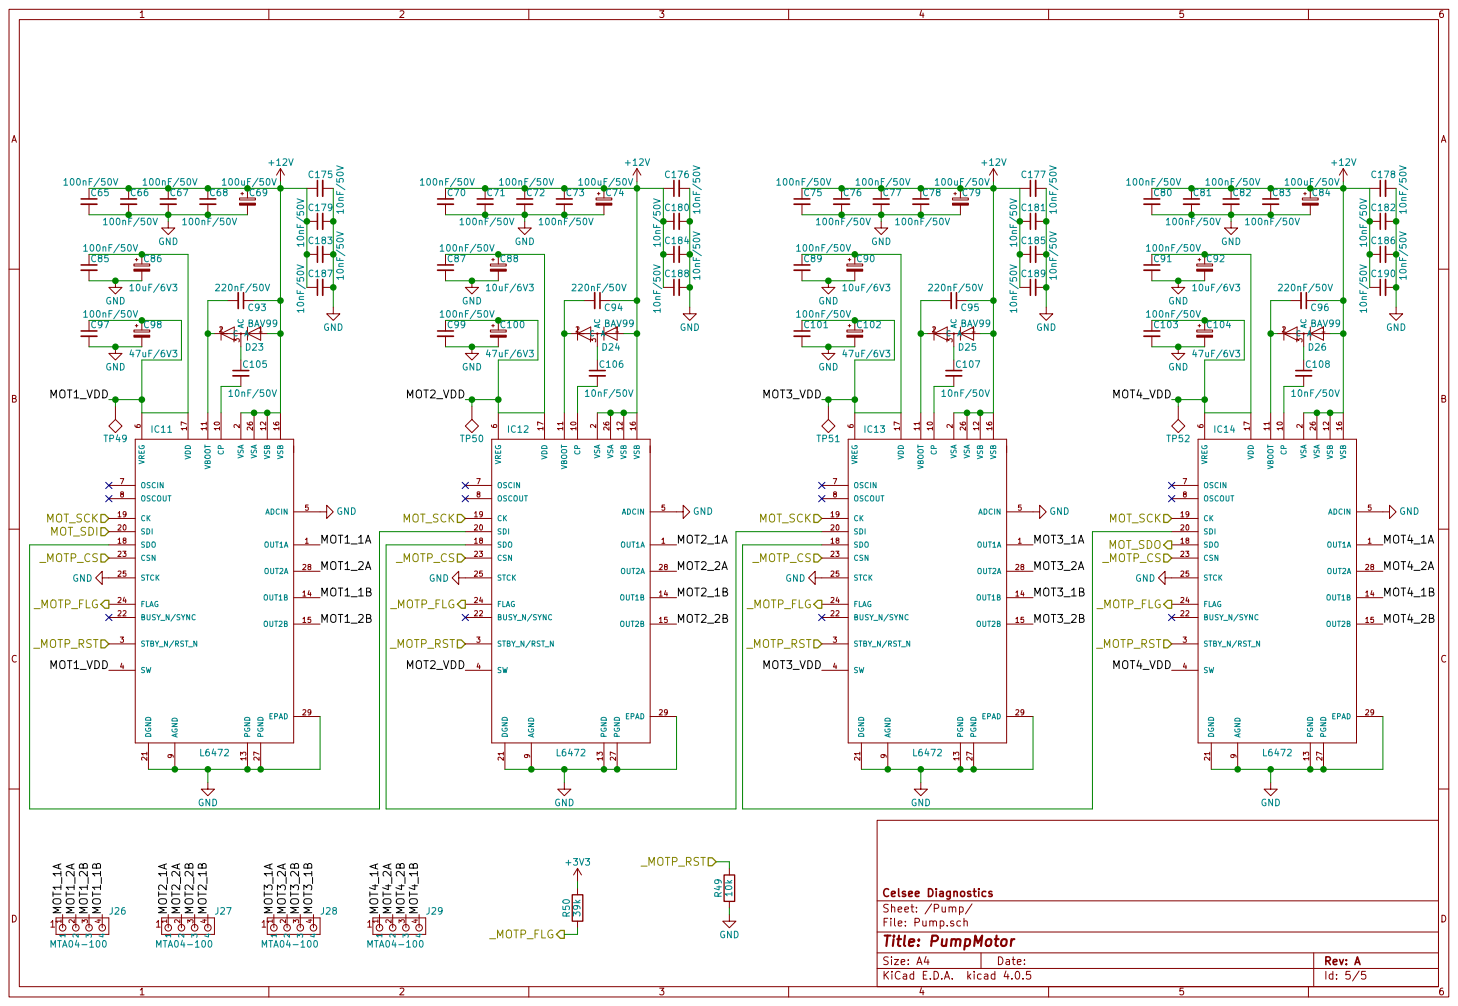
[picture p6: page 5]
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
