DenovoSciences/PCB-PREP400/Asby/GenesisV2DaughterAsbyDwg.pdf

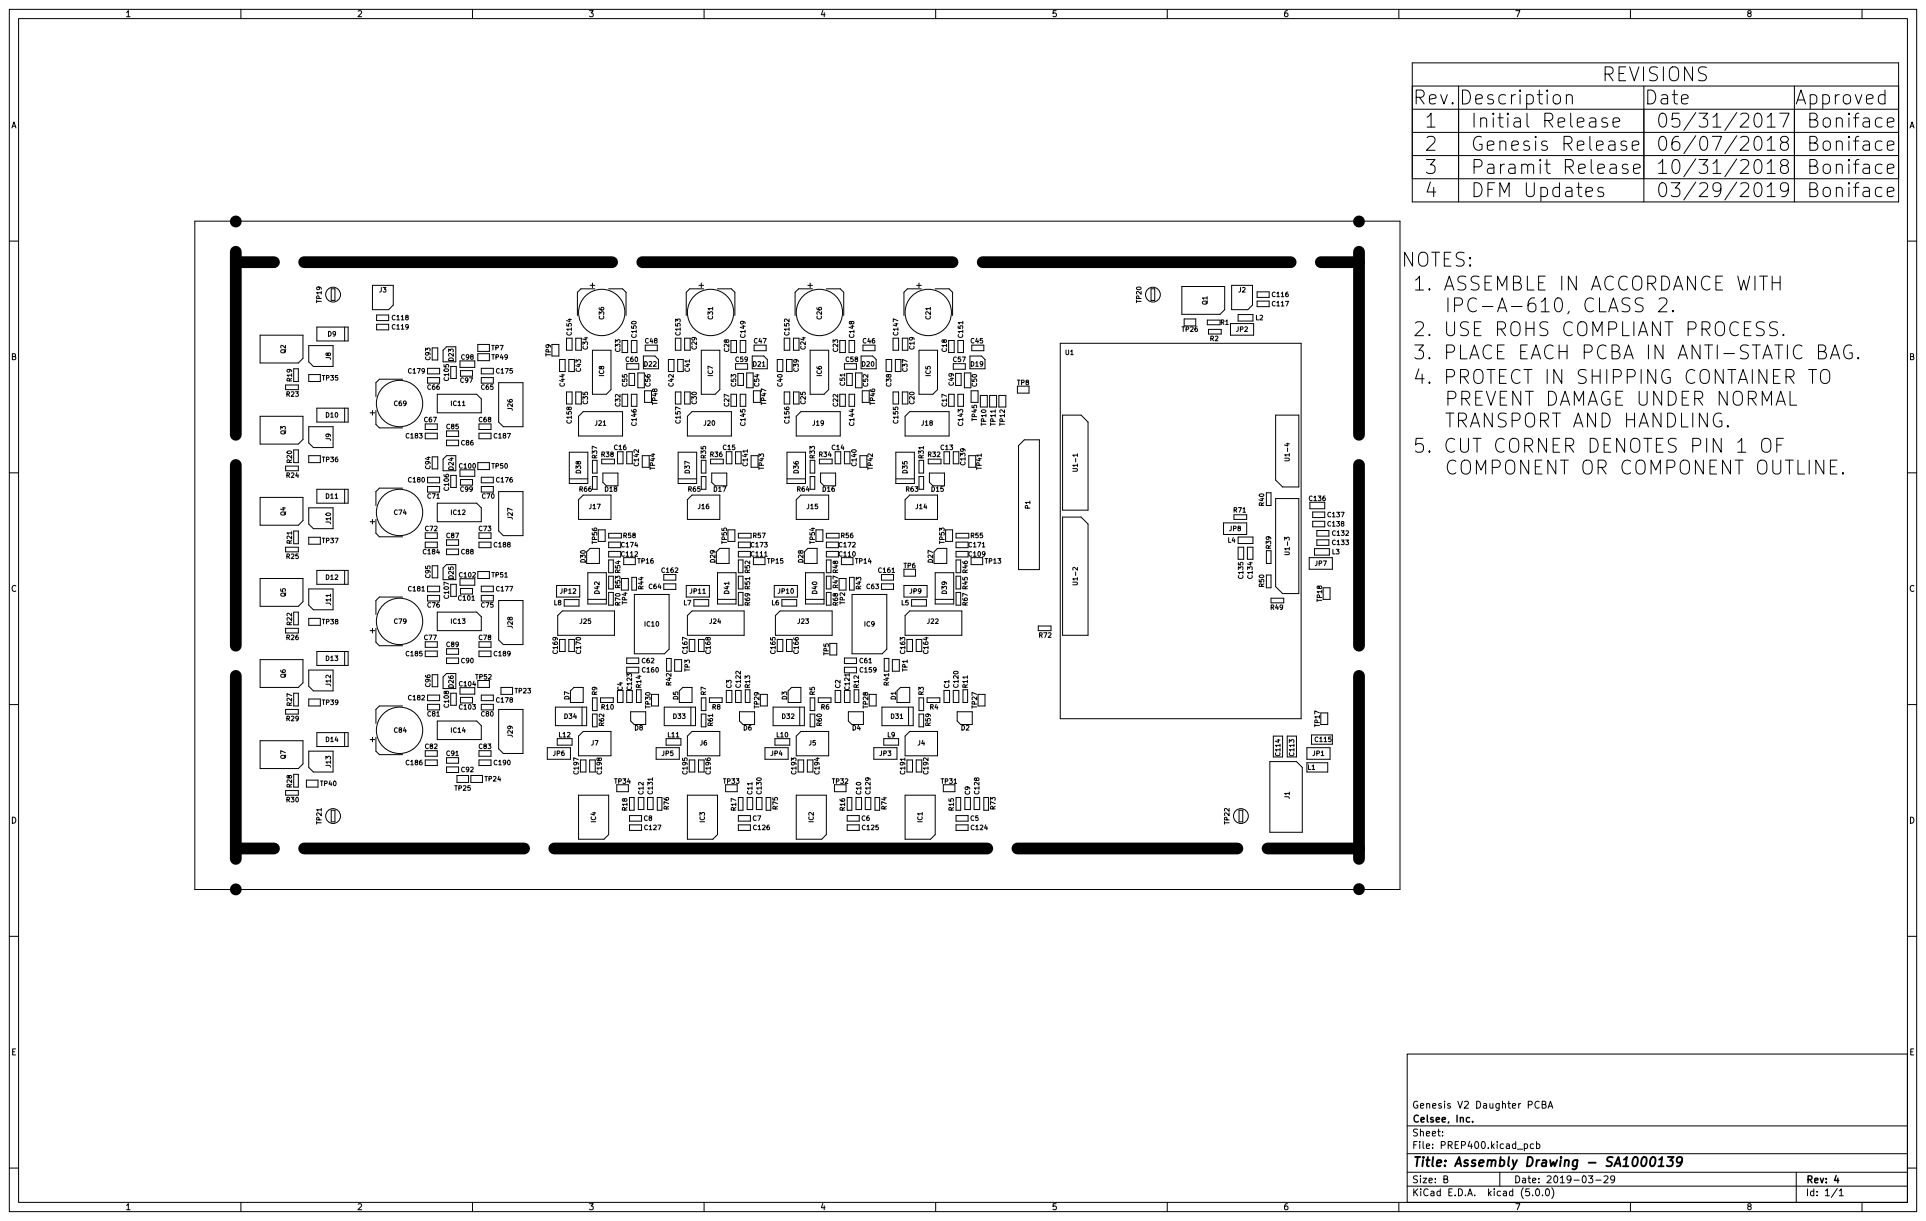
[picture p7: page 1]
