DenovoSciences/PCB-PREP400/Fab/GenesisV2DaughterFabDwg.pdf

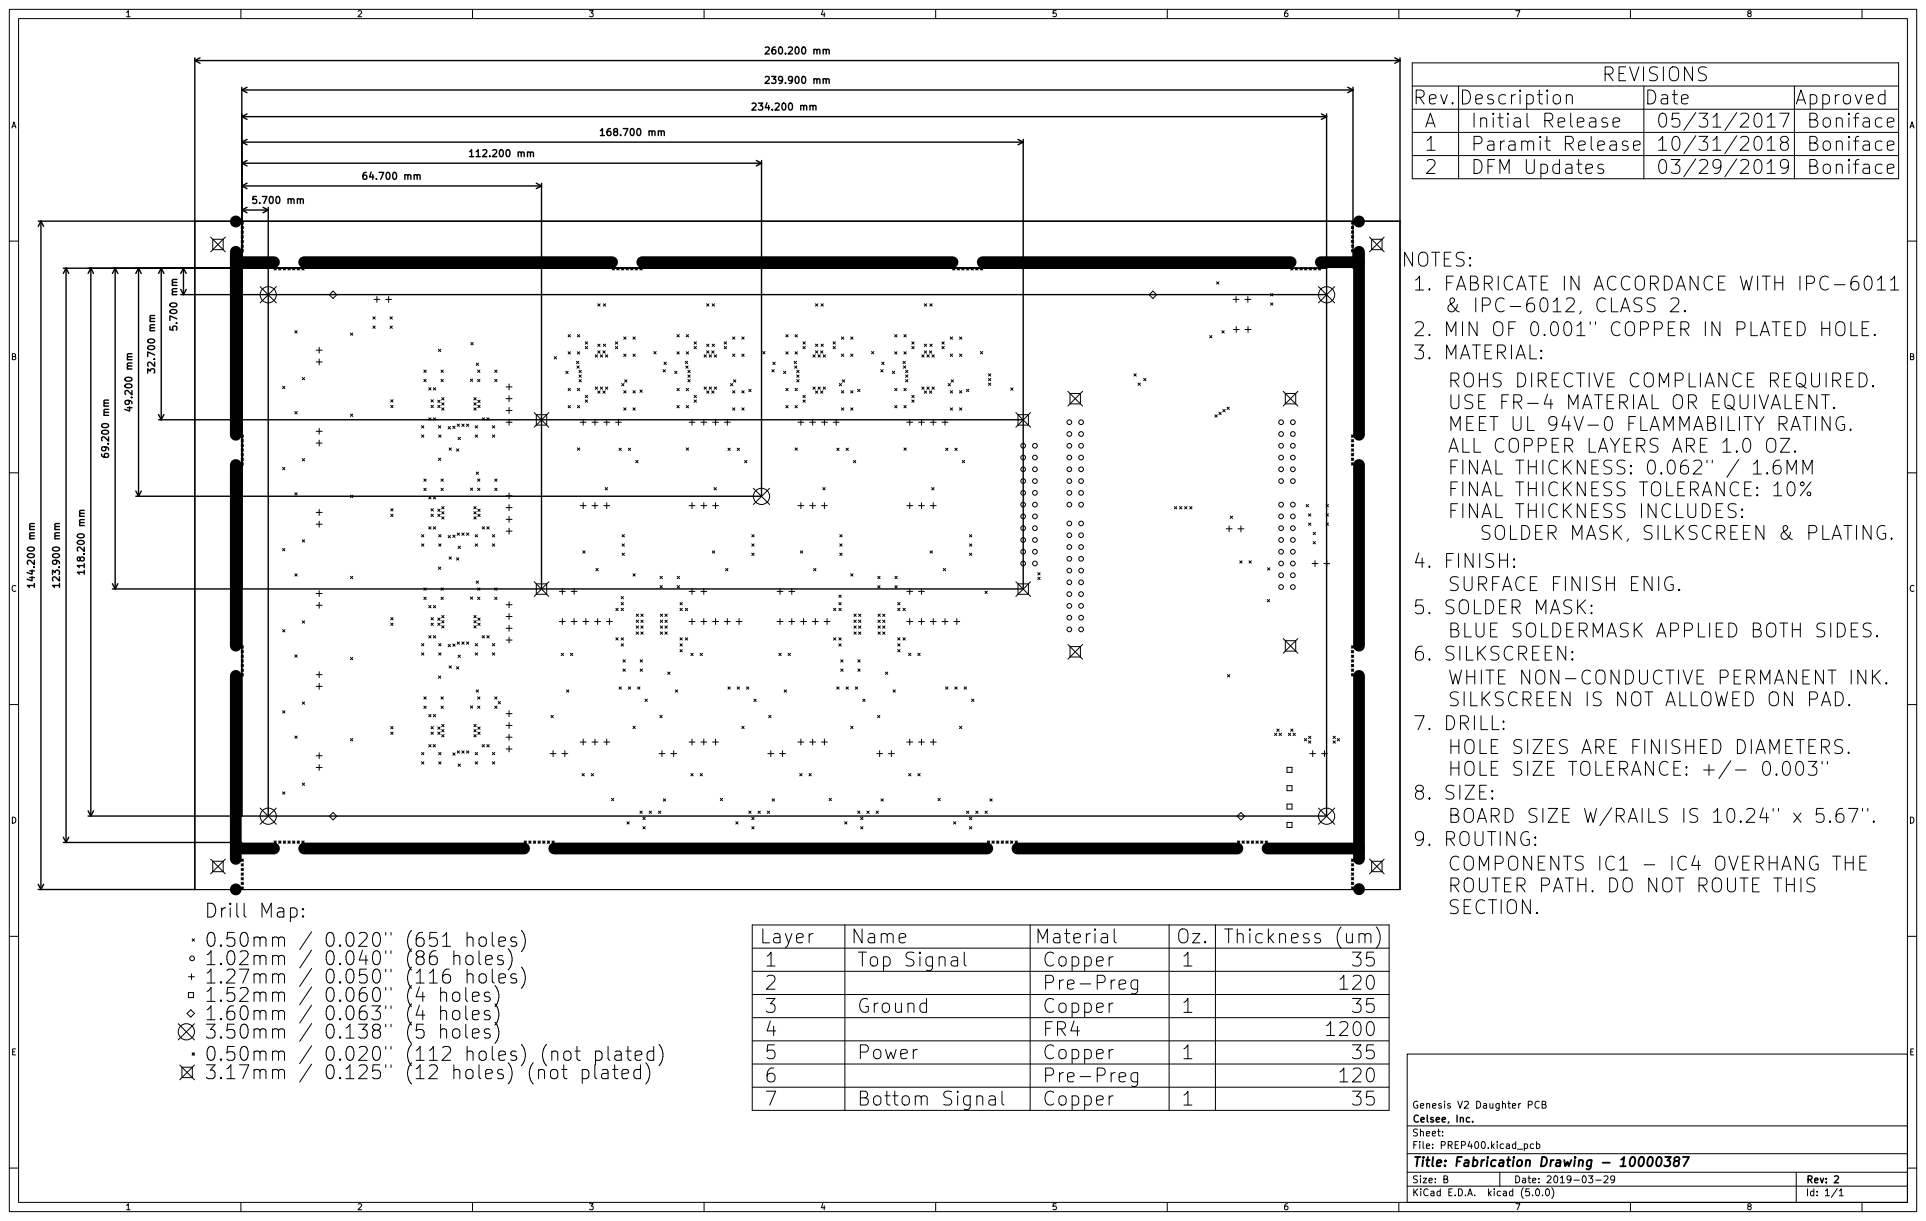
[picture p8: page 1]
