DenovoSciences/PCB-PREP400/PREP400.kicad_pcb

## KiCad design PREP400.kicad_pcb (2019-04-02)

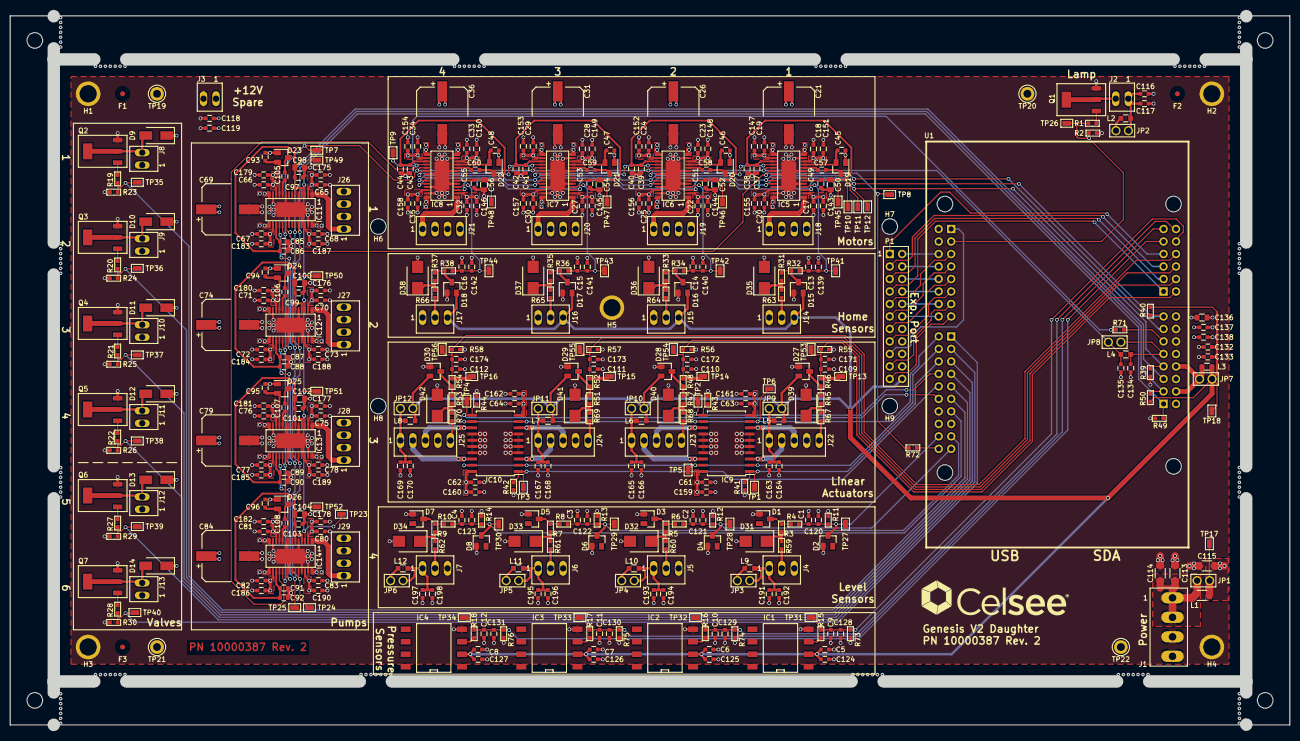
[picture p9: board PREP400.kicad_pcb from above]

Board: 4 copper layers, 260.2 x 144.2 mm, 467 parts (0 on the bottom side), 204 nets.

Parts:
C1, C2, C3, C4, C5, C6, C7, C8, C9, C10, C11, C12, C13, C14, C15, C16, C17, C18, C19, C20, C22, C23, C24, C25, C27, C28, C29, C30, C32, C33, C34, C35, C37, C39, C41, C43, C49, C51, C53, C55, C61, C62, C63, C64, C65, C66, C67, C68, C70, C71, C72, C73, C75, C76, C77, C78, C80, C81, C82, C83, C85, C87, C89, C91, C97, C99, C101, C103, C109, C110, C111, C112, C137: 100nF/50V; CAP_SMD_0603
C21, C26, C31, C36, C69, C74, C79, C84: 100uF/50V; CAP_SMD_RAD_10MM
C38, C40, C42, C44, C86, C88, C90, C92: 10uF/6V3; CAP_SMD_0603
C45, C46, C47, C48, C93, C94, C95, C96: 220nF/50V; CAP_SMD_0603
C50, C52, C54, C56, C98, C100, C102, C104: 47uF/6V3; CAP_SMD_0805
C57, C58, C59, C60, C105, C106, C107, C108, C120, C121, C122, C123, C124, C125, C126, C127, C128, C129, C130, C131, C138, C139, C140, C141, C142, C143, C144, C145, C146, C147, C148, C149, C150, C151, C152, C153, C154, C155, C156, C157, C158, C159, C160, C161, C162, C171, C172, C173, C174, C175, C176, C177, C178, C179, C180, C181, C182, C183, C184, C185, C186, C187, C188, C189, C190: 10nF/50V; CAP_SMD_0603
C113: 100nF/50V; CAP_SMD_1206
C114: 10nF/50V; CAP_SMD_1206
C115: 1206; CAP_SMD_1206
C116, C117, C118, C119, C132, C133, C134, C135, C163, C164, C165, C166, C167, C168, C169, C170, C191, C192, C193, C194, C195, C196, C197, C198: 0603; CAP_SMD_0603
C136: 0805; CAP_SMD_0805
D1, D3, D5, D7: BAT54; SOT-23-3
D2, D4, D6, D8: BZX84; SOT-23-3
D9, D10, D11, D12, D13, D14: 100V@1A; SMA
D15, D16, D17, D18, D27, D28, D29, D30: BAT54S; SOT-23-3
D19, D20, D21, D22, D23, D24, D25, D26: BAV99; SOT-23-3
D31, D32, D33, D34, D35, D36, D37, D38, D39, D40, D41, D42: SMB
F1, F2, F3: VAL**; FID_BTM_1MM
F1#2, F2#2, F3#2: VAL**; FID_TOP_1MM
H1, H2, H3, H4, H5: VAL**; MNT_3.5MM
H6, H7, H8, H9, H10, H11, H12, H13: VAL**; MNT_0.125IN
IC1, IC2, IC3, IC4: SSC; SMT-8
IC5, IC6, IC7, IC8, IC11, IC12, IC13, IC14: L6472; HTSSOP-28
IC9, IC10: L293DD; SOIC-20
J1: MTA04-156; CON_AMP_MTA156_1x4
J2, J3, J8, J9, J10, J11, J12, J13: MTA02-100; CON_AMP_MTA100_1x2
J4, J5, J6, J7, J14, J15, J16, J17: MTA03-100; CON_AMP_MTA100_1x3
J18, J19, J20, J21, J26, J27, J28, J29: MTA04-100; CON_AMP_MTA100_1x4
J22, J23, J24, J25: MTA05-100; CON_AMP_MTA100_1x5
JP1: jump_no; CON_JMP_100_1x2
JP2, JP3, JP4, JP5, JP6, JP7, JP8, JP9, JP10, JP11, JP12: jump_nc; CON_JMP_100_1x2
L1: 1206; FER_SMD_1206
L2, L3, L4, L5, L6, L7, L8, L9, L10, L11, L12: 0805; FER_SMD_0805
P1: CONN_EXP2; CON_SAMTEC_100_2x11
Q1, Q2, Q3, Q4, Q5, Q6, Q7: FQT13N06L; SOT_223
R1, R19, R20, R21, R22, R27, R28: 330; RES_SMD_0603
R2, R23, R24, R25, R26, R29, R30, R39, R41, R42, R43, R44, R49: 10k; RES_SMD_0603
R3, R5, R7, R9, R31, R33, R35, R37, R45, R47, R51, R53, R59, R60, R61, R62, R63, R64, R65, R66, R67, R68, R69, R70: 100; RES_SMD_0603
R4, R6, R8, R10: 1.5k; RES_SMD_0603
R11, R12, R13, R14, R55, R56, R57, R58, R73, R74, R75, R76: 100k; RES_SMD_0603
R15, R16, R17, R18, R32, R34, R36, R38, R46, R48, R52, R54: 1k; RES_SMD_0603
R40, R50: 39k; RES_SMD_0603
R71, R72: 0; RES_SMD_0603
TP1, TP2, TP3, TP4, TP5, TP6, TP7, TP8, TP9, TP10, TP11, TP12, TP13, TP14, TP15, TP16, TP17, TP18, TP23, TP24, TP25, TP26, TP27, TP28, TP29, TP30, TP31, TP32, TP33, TP34, TP35, TP36, TP37, TP38, TP39, TP40, TP41, TP42, TP43, TP44, TP45, TP46, TP47, TP48, TP49, TP50, TP51, TP52, TP53, TP54, TP55, TP56: TP; TP_SMD_0603
TP19, TP20, TP21, TP22: TP; Test_Point_Keystone_5005-5009_Compact
U1: FRDM-KL25Z

Connections:
+3V3: C5.1, C6.1, C7.1, C8.1, C124.1, C125.1, C126.1, C127.1, C132.1, C133.1, D15.2, D16.2, D17.2, D18.2, D27.2, D28.2, D29.2, D30.2, IC1.2, IC2.2, IC3.2, IC4.2, J14.3, J15.3, J16.3, J17.3, JP7.2, JP9.2, JP10.2, JP11.2, JP12.2, L3.2, L5.2, L6.2, L7.2, L8.2, P1.22, R40.2, R50.2, TP18.1
+12V: C17.1, C18.1, C19.1, C20.1, C21.1, C22.1, C23.1, C24.1, C25.1, C26.1, C27.1, C28.1, C29.1, C30.1, C31.1, C32.1, C33.1, C34.1, C35.1, C36.1, C45.1, C46.1, C47.1, C48.1, C61.2, C62.2, C63.1, C64.1, C65.1, C66.1, C67.1, C68.1, C69.1, C70.1, C71.1, C72.1, C73.1, C74.1, C75.1, C76.1, C77.1, C78.1, C79.1, C80.1, C81.1, C82.1, C83.1, C84.1, C93.1, C94.1, C95.1, C96.1, C115.1, C118.1, C119.1, C136.1, C137.1, C138.1, C143.1, C144.1, C145.1, C146.1, C147.1, C148.1, C149.1, C150.1, C151.1, C152.1, C153.1, C154.1, C155.1, C156.1, C157.1, C158.1, C159.2, C160.2, C161.1, C162.1, C175.1, C176.1, C177.1, C178.1, C179.1, C180.1, C181.1, C182.1, C183.1, C184.1, C185.1, C186.1, C187.1, C188.1, C189.1, C190.1, D9.1, D10.1, D11.1, D12.1, D13.1, D14.1, D19.1, D20.1, D21.1, D22.1, D23.1, D24.1, D25.1, D26.1, IC5.2, IC5.12, IC5.16, IC5.26, IC6.2, IC6.12, IC6.16, IC6.26, IC7.2, IC7.12, IC7.16, IC7.26, IC8.2, IC8.12, IC8.16, IC8.26, IC9.10, IC9.20, IC10.10, IC10.20, IC11.2, IC11.12, IC11.16, IC11.26, IC12.2, IC12.12, IC12.16, IC12.26, IC13.2, IC13.12, IC13.16, IC13.26, IC14.2, IC14.12, IC14.16, IC14.26, J3.1, J8.1, J9.1, J10.1, J11.1, J12.1, J13.1, JP1.2, JP2.1, JP3.1, JP4.1, JP5.1, JP6.1, L1.2, L2.2, L9.1, L10.1, L11.1, L12.1, P1.14, P1.16, TP17.1, U1.4-16
/LinearActuator/LIN_OUT1A: IC9.3, J22.2
/LinearActuator/LIN_OUT1B: IC9.8, J22.3
/LinearActuator/LIN_OUT2A: IC9.18, J23.2
/LinearActuator/LIN_OUT2B: IC9.13, J23.3
/LinearActuator/LIN_OUT3A: IC10.3, J24.2
/LinearActuator/LIN_OUT3B: IC10.8, J24.3
/LinearActuator/LIN_OUT4A: IC10.18, J25.2
/LinearActuator/LIN_OUT4B: IC10.13, J25.3
/Microcontroller/EXP_A0: P1.1, U1.3-7
/Microcontroller/EXP_A1: P1.3, U1.3-5
/Microcontroller/EXP_A2: P1.5, U1.3-3
/Microcontroller/EXP_A3: P1.7, U1.3-1
/Microcontroller/EXP_D0: P1.9, U1.1-5
/Microcontroller/EXP_D1_SPI0_CS: P1.11, U1.1-7
/Microcontroller/EXP_D2_SPI0_SCK: P1.13, U1.1-9
/Microcontroller/EXP_D3_SPI0_MOSI: P1.15, U1.1-11
/Microcontroller/EXP_D4_SPI0_MISO: P1.17, U1.1-1
/Microcontroller/EXP_D5_I2C1_SCL: P1.19, U1.1-13
/Microcontroller/EXP_D6_I2C1_SDA: P1.21, U1.1-15
/Microcontroller/EXP_D7: P1.12, U1.1-16
/Microcontroller/EXP_D8: P1.10, U1.1-14
/Microcontroller/EXP_D9: P1.8, U1.1-12
/Microcontroller/EXP_D10: P1.6, U1.1-10
/Microcontroller/EXP_D11: P1.4, U1.1-8
/Microcontroller/EXP_D12: P1.2, U1.1-6
/Microcontroller/LAMP: R1.2, R2.1, TP26.1, U1.1-3
/Microcontroller/LEVEL1: C1.1, C120.1, D2.3, R4.1, R11.1, TP27.1, U1.2-18
/Microcontroller/LEVEL2: C2.1, C121.1, D4.3, R6.1, R12.1, TP28.1, U1.2-19
/Microcontroller/LEVEL3: C3.1, C122.1, D6.3, R8.1, R13.1, TP29.1, U1.2-17
/Microcontroller/LEVEL4: C4.1, C123.1, D8.3, R10.1, R14.1, TP30.1, U1.2-13
/Microcontroller/LIN_ACT_DIR: IC9.2, IC9.19, IC10.2, IC10.19, TP5.1, U1.2-4
/Microcontroller/LIN_ACT_EN1: IC9.1, R41.1, TP1.1, U1.2-6
/Microcontroller/LIN_ACT_EN2: IC9.11, R43.2, TP2.1, U1.2-8
/Microcontroller/LIN_ACT_EN3: IC10.1, R42.1, TP3.1, U1.2-10
/Microcontroller/LIN_ACT_EN4: IC10.11, R44.2, TP4.1, U1.2-12
/Microcontroller/LIN_ACT_POS1: C109.1, C171.1, R46.2, R55.1, TP13.1, TP53.1, U1.3-2
/Microcontroller/LIN_ACT_POS2: C110.1, C172.1, R48.2, R56.1, TP14.1, TP54.1, U1.3-4
/Microcontroller/LIN_ACT_POS3: C111.1, C173.1, R52.2, R57.1, TP15.1, TP55.1, U1.3-6
/Microcontroller/LIN_ACT_POS4: C112.1, C174.1, R54.2, R58.1, TP16.1, TP56.1, U1.3-8
/Microcontroller/PRESSURE1: C9.1, C128.1, R15.1, R73.1, TP31.1, U1.3-10
/Microcontroller/PRESSURE2: C10.1, C129.1, R16.1, R74.1, TP32.1, U1.3-12
/Microcontroller/PRESSURE3: C11.1, C130.1, R17.1, R75.1, TP33.1, U1.3-11
/Microcontroller/PRESSURE4: C12.1, C131.1, R18.1, R76.1, TP34.1, U1.3-9
/Microcontroller/VALVE1: R19.2, R23.1, TP35.1, U1.2-11
/Microcontroller/VALVE2: R20.2, R24.1, TP36.1, U1.2-9
/Microcontroller/VALVE3: R21.2, R25.1, TP37.1, U1.2-7
/Microcontroller/VALVE4: R22.2, R26.1, TP38.1, U1.2-5
/Microcontroller/VALVE5: R27.2, R29.1, TP39.1, U1.2-3
/Microcontroller/VALVE6: R28.2, R30.1, TP40.1, U1.2-1
/Microcontroller/_LIN_ACT_DIR: IC9.9, IC9.12, IC10.9, IC10.12, TP6.1, U1.2-2
/Motor/MOT1_1A: IC5.1, J18.1
/Motor/MOT1_1B: IC5.14, J18.4
/Motor/MOT1_2A: IC5.28, J18.2
/Motor/MOT1_2B: IC5.15, J18.3
/Motor/MOT1_HOME: C13.1, C139.1, IC5.4, R32.2, TP41.1
/Motor/MOT2_1A: IC6.1, J19.1
/Motor/MOT2_1B: IC6.14, J19.4
/Motor/MOT2_2A: IC6.28, J19.2
/Motor/MOT2_2B: IC6.15, J19.3
/Motor/MOT2_HOME: C14.1, C140.1, IC6.4, R34.2, TP42.1
/Motor/MOT3_1A: IC7.1, J20.1
/Motor/MOT3_1B: IC7.14, J20.4
/Motor/MOT3_2A: IC7.28, J20.2
/Motor/MOT3_2B: IC7.15, J20.3
/Motor/MOT3_HOME: C15.1, C141.1, IC7.4, R36.2, TP43.1
/Motor/MOT4_1A: IC8.1, J21.1
/Motor/MOT4_1B: IC8.14, J21.4
/Motor/MOT4_2A: IC8.28, J21.2
/Motor/MOT4_2B: IC8.15, J21.3
/Motor/MOT4_HOME: C16.1, C142.1, IC8.4, R38.2, TP44.1
/Motor/MOT_SCK: C135.1, IC5.19, IC6.19, IC7.19, IC8.19, IC11.19, IC12.19, IC13.19, IC14.19, JP8.2, L4.2, TP7.1
/Motor/MOT_SDI: IC5.20, IC11.20, R72.2, TP8.1
/Motor/MOT_SDO: IC8.18, IC14.18, R71.1, TP9.1
/Motor/_MOTC_CS: IC5.23, IC6.23, IC7.23, IC8.23, TP10.1, U1.4-13
/Motor/_MOTC_FLG: IC5.24, IC6.24, IC7.24, IC8.24, R40.1, TP11.1, U1.4-15
/Motor/_MOTC_RST: IC5.3, IC6.3, IC7.3, IC8.3, R39.2, TP12.1, U1.4-7
/Pump/MOT1_1A: IC11.1, J26.1
/Pump/MOT1_1B: IC11.14, J26.4
/Pump/MOT1_2A: IC11.28, J26.2
/Pump/MOT1_2B: IC11.15, J26.3
/Pump/MOT1_VDD: C85.1, C86.1, C97.1, C98.1, IC11.4, IC11.6, IC11.17, TP49.1
/Pump/MOT2_1A: IC12.1, J27.1
/Pump/MOT2_1B: IC12.14, J27.4
/Pump/MOT2_2A: IC12.28, J27.2
/Pump/MOT2_2B: IC12.15, J27.3
/Pump/MOT2_VDD: C87.1, C88.1, C99.1, C100.1, IC12.4, IC12.6, IC12.17, TP50.1
/Pump/MOT3_1A: IC13.1, J28.1
/Pump/MOT3_1B: IC13.14, J28.4
/Pump/MOT3_2A: IC13.28, J28.2
/Pump/MOT3_2B: IC13.15, J28.3
/Pump/MOT3_VDD: C89.1, C90.1, C101.1, C102.1, IC13.4, IC13.6, IC13.17, TP51.1
/Pump/MOT4_1A: IC14.1, J29.1
/Pump/MOT4_1B: IC14.14, J29.4
/Pump/MOT4_2A: IC14.28, J29.2
/Pump/MOT4_2B: IC14.15, J29.3
/Pump/MOT4_VDD: C91.1, C92.1, C103.1, C104.1, IC14.4, IC14.6, IC14.17, TP52.1
/Pump/_MOTP_CS: IC11.23, IC12.23, IC13.23, IC14.23, TP25.1, U1.4-5
/Pump/_MOTP_FLG: IC11.24, IC12.24, IC13.24, IC14.24, R50.1, TP24.1, U1.4-3
/Pump/_MOTP_RST: IC11.3, IC12.3, IC13.3, IC14.3, R49.2, TP23.1, U1.4-1
GND: C1.2, C2.2, C3.2, C4.2, C5.2, C6.2, C7.2, C8.2, C9.2, C10.2, C11.2, C12.2, C13.2, C14.2, C15.2, C16.2, C17.2, C18.2, C19.2, C20.2, C21.2, C22.2, C23.2, C24.2, C25.2, C26.2, C27.2, C28.2, C29.2, C30.2, C31.2, C32.2, C33.2, C34.2, C35.2, C36.2, C37.2, C38.2, C39.2, C40.2, C41.2, C42.2, C43.2, C44.2, C49.2, C50.2, C51.2, C52.2, C53.2, C54.2, C55.2, C56.2, C61.1, C62.1, C63.2, C64.2, C65.2, C66.2, C67.2, C68.2, C69.2, C70.2, C71.2, C72.2, C73.2, C74.2, C75.2, C76.2, C77.2, C78.2, C79.2, C80.2, C81.2, C82.2, C83.2, C84.2, C85.2, C86.2, C87.2, C88.2, C89.2, C90.2, C91.2, C92.2, C97.2, C98.2, C99.2, C100.2, C101.2, C102.2, C103.2, C104.2, C109.2, C110.2, C111.2, C112.2, C113.2, C114.2, C115.2, C116.2, C117.2, C118.2, C119.2, C120.2, C121.2, C122.2, C123.2, C124.2, C125.2, C126.2, C127.2, C128.2, C129.2, C130.2, C131.2, C132.2, C133.2, C134.2, C135.2, C136.2, C137.2, C138.2, C139.2, C140.2, C141.2, C142.2, C143.2, C144.2, C145.2, C146.2, C147.2, C148.2, C149.2, C150.2, C151.2, C152.2, C153.2, C154.2, C155.2, C156.2, C157.2, C158.2, C159.1, C160.1, C161.2, C162.2, C163.1, C164.1, C165.1, C166.1, C167.1, C168.1, C169.1, C170.1, C171.2, C172.2, C173.2, C174.2, C175.2, C176.2, C177.2, C178.2, C179.2, C180.2, C181.2, C182.2, C183.2, C184.2, C185.2, C186.2, C187.2, C188.2, C189.2, C190.2, C191.1, C192.1, C193.1, C194.1, C195.1, C196.1, C197.1, C198.1, D1.1, D2.1, D3.1, D4.1, D5.1, D6.1, D7.1, D8.1, D15.1, D16.1, D17.1, D18.1, D27.1, D28.1, D29.1, D30.1, D31.2, D32.2, D33.2, D34.2, D35.2, D36.2, D37.2, D38.2, D39.2, D40.2, D41.2, D42.2, H1.1, H2.1, H3.1, H4.1, H5.1, IC1.4, IC2.4, IC3.4, IC4.4, IC5.5, IC5.9, IC5.13, IC5.21, IC5.25, IC5.27, IC5.29, IC6.5, IC6.9, IC6.13, IC6.21, IC6.25, IC6.27, IC6.29, IC7.5, IC7.9, IC7.13, IC7.21, IC7.25, IC7.27, IC7.29, IC8.5, IC8.9, IC8.13, IC8.21, IC8.25, IC8.27, IC8.29, IC9.4, IC9.5, IC9.6, IC9.7, IC9.14, IC9.15, IC9.16, IC9.17, IC10.4, IC10.5, IC10.6, IC10.7, IC10.14, IC10.15, IC10.16, IC10.17, IC11.5, IC11.9, IC11.13, IC11.21, IC11.25, IC11.27, IC11.29, IC12.5, IC12.9, IC12.13, IC12.21, IC12.25, IC12.27, IC12.29, IC13.5, IC13.9, IC13.13, IC13.21, IC13.25, IC13.27, IC13.29, IC14.5, IC14.9, IC14.13, IC14.21, IC14.25, IC14.27, IC14.29, J1.3, J1.4, J3.2, J4.3, J5.3, J6.3, J7.3, J14.1, J15.1, J16.1, J17.1, J22.4, J23.4, J24.4, J25.4, P1.18, P1.20, Q1.S, Q2.S, Q3.S, Q4.S, Q5.S, Q6.S, Q7.S, R2.2, R11.2, R12.2, R13.2, R14.2, R23.2, R24.2, R25.2, R26.2, R29.2, R30.2, R39.1, R41.2, R42.2, R43.1, R44.1, R49.1, R55.2, R56.2, R57.2, R58.2, R73.2, R74.2, R75.2, R76.2, TP19.1, TP20.1, TP21.1, TP22.1, U1.2-14, U1.4-12, U1.4-14
unnamed: C37.1, C38.1, C49.1, C50.1, IC5.6, IC5.17, TP45.1
unnamed: C39.1, C40.1, C51.1, C52.1, IC6.6, IC6.17, TP46.1
unnamed: C41.1, C42.1, C53.1, C54.1, IC7.6, IC7.17, TP47.1
unnamed: C43.1, C44.1, C55.1, C56.1, IC8.6, IC8.17, TP48.1
unnamed: C45.2, D19.2, IC5.11
unnamed: C46.2, D20.2, IC6.11
unnamed: C47.2, D21.2, IC7.11
unnamed: C48.2, D22.2, IC8.11
unnamed: C57.1, D19.3
unnamed: C57.2, IC5.10
unnamed: C58.1, D20.3
unnamed: C58.2, IC6.10
unnamed: C59.1, D21.3
unnamed: C59.2, IC7.10
unnamed: C60.1, D22.3
unnamed: C60.2, IC8.10
unnamed: C93.2, D23.2, IC11.11
unnamed: C94.2, D24.2, IC12.11
unnamed: C95.2, D25.2, IC13.11
unnamed: C96.2, D26.2, IC14.11
unnamed: C105.1, D23.3
unnamed: C105.2, IC11.10
unnamed: C106.1, D24.3
unnamed: C106.2, IC12.10
unnamed: C107.1, D25.3
unnamed: C107.2, IC13.10
unnamed: C108.1, D26.3
unnamed: C108.2, IC14.10
unnamed: C113.1, C114.1, J1.1, J1.2, JP1.1, L1.1
unnamed: C116.1, C117.1, J2.1, JP2.2, L2.1
unnamed: C134.1, JP8.1, L4.1, U1.4-9
unnamed: C163.2, C164.2, J22.1, JP9.1, L5.1
unnamed: C165.2, C166.2, J23.1, JP10.1, L6.1
unnamed: C167.2, C168.2, J24.1, JP11.1, L7.1
unnamed: C169.2, C170.2, J25.1, JP12.1, L8.1
unnamed: C191.2, C192.2, J4.1, JP3.2, L9.2
unnamed: C193.2, C194.2, J5.1, JP4.2, L10.2
unnamed: C195.2, C196.2, J6.1, JP5.2, L11.2
unnamed: C197.2, C198.2, J7.1, JP6.2, L12.2
unnamed: D1.3, R3.1, R4.2
unnamed: D3.3, R5.1, R6.2
unnamed: D5.3, R7.1, R8.2
unnamed: D7.3, R9.1, R10.2
unnamed: D9.2, J8.2, Q2.D
unnamed: D10.2, J9.2, Q3.D
unnamed: D11.2, J10.2, Q4.D
unnamed: D12.2, J11.2, Q5.D
unnamed: D13.2, J12.2, Q6.D
unnamed: D14.2, J13.2, Q7.D
unnamed: D15.3, R31.2, R32.1
unnamed: D16.3, R33.2, R34.1
unnamed: D17.3, R35.2, R36.1
unnamed: D18.3, R37.2, R38.1
unnamed: D27.3, R45.2, R46.1
unnamed: D28.3, R47.2, R48.1
unnamed: D29.3, R51.2, R52.1
unnamed: D30.3, R53.2, R54.1
unnamed: D31.1, R3.2, R59.1
unnamed: D32.1, R5.2, R60.1
unnamed: D33.1, R7.2, R61.1
unnamed: D34.1, R9.2, R62.1
unnamed: D35.1, R31.1, R63.2
unnamed: D36.1, R33.1, R64.2
unnamed: D37.1, R35.1, R65.2
unnamed: D38.1, R37.1, R66.2
unnamed: D39.1, R45.1, R67.2
unnamed: D40.1, R47.1, R68.2
unnamed: D41.1, R51.1, R69.2
unnamed: D42.1, R53.1, R70.2
unnamed: IC1.3, R15.2
unnamed: IC2.3, R16.2
unnamed: IC3.3, R17.2
unnamed: IC4.3, R18.2
unnamed: IC5.18, IC6.20
unnamed: IC6.18, IC7.20
unnamed: IC7.18, IC8.20
unnamed: IC11.18, IC12.20
unnamed: IC12.18, IC13.20
unnamed: IC13.18, IC14.20
unnamed: J2.2, Q1.D
unnamed: J4.2, R59.2
unnamed: J5.2, R60.2
unnamed: J6.2, R61.2
unnamed: J7.2, R62.2
unnamed: J14.2, R63.1
unnamed: J15.2, R64.1
unnamed: J16.2, R65.1
unnamed: J17.2, R66.1
unnamed: J22.5, R67.1
unnamed: J23.5, R68.1
unnamed: J24.5, R69.1
unnamed: J25.5, R70.1
unnamed: JP7.1, L3.1, U1.4-4, U1.4-8
unnamed: Q1.G, R1.1
unnamed: Q2.G, R19.1
unnamed: Q3.G, R20.1
unnamed: Q4.G, R21.1
unnamed: Q5.G, R22.1
unnamed: Q6.G, R27.1
unnamed: Q7.G, R28.1
unnamed: R71.2, U1.4-11
unnamed: R72.1, U1.2-20
