DenovoSciences/PCB-PREP400/(commit log)

2018-06-06 Initial release of PREP400 PCB
    [LinearActuator.sch, Microcontroller.sch, Motor.sch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]
2018-06-06 Scrubbed BOM for obsolete parts
    [PREP400-BOM.xlsx]
2018-06-06 Added expansion connector for Genesis Aux PCB
    [PREP400-BOM.xlsx]
2018-06-07 Added Celsee part numbers
    [PREP400-BOM.xlsx]
2018-10-01 Scrubbed BOM
    [PREP400-BOM.xlsx]
2018-10-01 Added Gronk Daughter BOM
    [GronkDaughter-BOM.xlsx, PREP400-BOM.xlsx]
2018-10-05 Added Celsee part numbers.
    [GronkDaughter-BOM.xlsx]
2018-10-18 Added fab drawing for assembly
    [PREP400.kicad_pcb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]
2018-10-23 Added revision column. Updated manufacturer part numbers.
    [GenesisV2DaughterBOM-Rev2.xlsx, GronkDaughter-BOM.xlsx]
2018-10-25 Added part numbers
    [GenesisV2DaughterBOM-Rev2.xlsx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]
2018-10-31 Updated pressure sensor
    [GenesisV2DaughterBOM-Rev2.xlsx, GenesisV2DaughterBOM-Rev3.xlsx]
2018-11-13 Fixed component typos
    [GenesisV2DaughterBOM-Rev3.xlsx]
2018-11-28 Paramit release
    [GenesisV2DaughterBOM-Rev3.xlsx, GenesisV2DaughterBOM.xlsx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]
2019-01-25 Add new BOM format
    [GenesisV2DaughterBOM.xlsx, SA1000139 - BOM - Assy, PCBA, Daughter, Genesis V2-Rev_4.xlsx]
2019-04-02 Address DFM from Paramit
    [PREP400-B.Cu.gbl, PREP400-B.Mask.gbs, PREP400-B.Paste.gbp, PREP400-B.SilkS.gbo, PREP400-Edge.Cuts.gm1, PREP400-F.Cu.gtl, PREP400-F.Mask.gts, PREP400-F.Paste.gtp]
